999matej999/pico-kit-pcb/README.md

# Pico Kit PCB #

## Files
* [Schematic](./rpi_pico_kit/RPi-Pico-Kit.pdf)
* [Gerber](./rpi_pico_kit/gerbers/)

## 3D Model
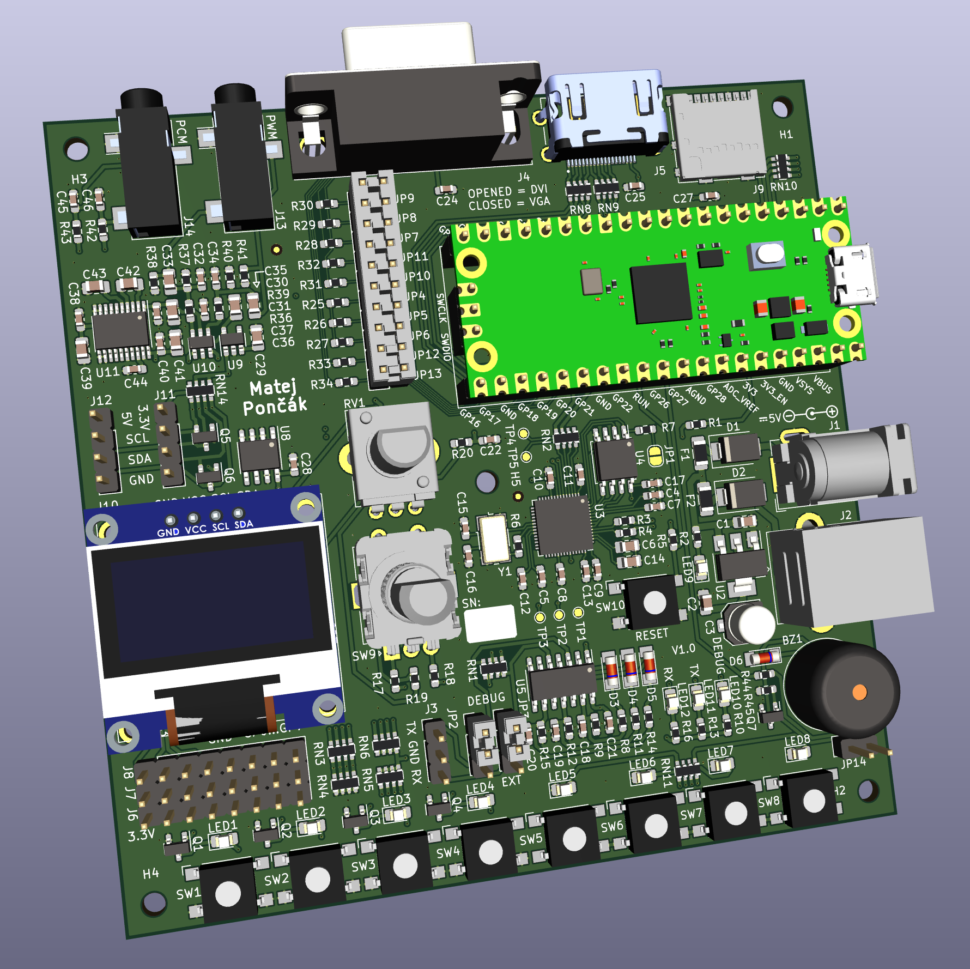
[picture p1: img/3D_model_top.png]


## Layout
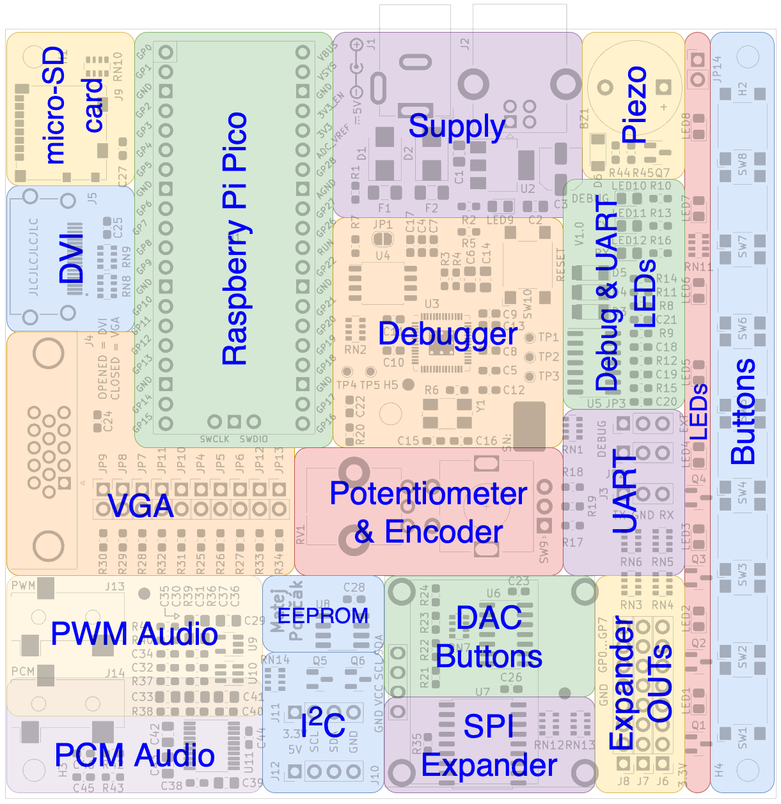
[picture p2: img/layout.png]
