999matej999/pico-kit-pcb/kit_pinout.xlsx

Sheet: Hárok1
TX + LED | GP0 | 1 | 40 | VBUS
RX + LED | GP1 | 2 | 39 | VSYS
 | GND | 3 | 38 | GND
 | GP2 | 4 | 37 | 3V3_EN
 | GP3 | 5 | 36 | 3V3(OUT)
SDA | GP4 | 6 | 35
SCL | GP5 | 7 | 34 | GP28 | ENC_BUTTON
 | GND | 8 | 33 | GND
LED1 | GP6 | 9 | 32 | GP27 | TEMP
LED2 | GP7 | 10 | 31 | GP26 | BUTTONS
LED3/L/I2S | GP8 | 11 | 30 | RUN | RESET
LED4/R/I2S | GP9 | 12 | 29 | GP22 | ENC_B
 | GND | 13 | 28 | GND
I2S | GP10 | 14 | 27 | GP21 | ENC_A
VGA | GP11 | 15 | 26 | GP20 | VGA
VGA/HDMI | GP12 | 16 | 25 | GP19 | VGA/HDMI
VGA/HDMI | GP13 | 17 | 24 | GP18 | VGA/HDMI
 | GND | 18 | 23 | GND
VGA/HDMI | GP14 | 19 | 22 | GP17 | VGA/HDMI
VGA/HDMI | GP15 | 20 | 21 | GP16 | VGA/HDMI

Sheet: Hárok2
TX + LED | GP0 | 1 | 40 | VBUS
RX + LED | GP1 | 2 | 39 | VSYS
 | GND | 3 | 38 | GND
SDA | GP2 | 4 | 37 | 3V3_EN
SCL | GP3 | 5 | 36 | 3V3(OUT)
SPI RX (MISO) | GP4 | 6 | 35
SPI SD CS | GP5 | 7 | 34 | GP28 | DAC_BUTTONS
 | GND | 8 | 33 | GND
LED1/SPI SCK | GP6 | 9 | 32 | GP27 | POTENTIOMETER
LED2/SPI TX (MOSI) | GP7 | 10 | 31 | GP26 | SPI EXPANDER CS
LED3/PWM L/I2S_LRCK | GP8 | 11 | 30 | RUN | RESET
LED4/PWM R/I2S_BCK | GP9 | 12 | 29 | GP22 | ENC_B
 | GND | 13 | 28 | GND
PIEZO/I2S_DIN | GP10 | 14 | 27 | GP21 | ENC_A
VGA_B0/ENC_SW | GP11 | 15 | 26 | GP20 | VGA_VSYNC
VGA_B1/DVI_D0+ | GP12 | 16 | 25 | GP19 | VGA_HSYNC/DVI_D1-
VGA_G0/DVI_D0- | GP13 | 17 | 24 | GP18 | VGA_R2/DVI_D1+
 | GND | 18 | 23 | GND
VGA_G1/DVI_CLK+ | GP14 | 19 | 22 | GP17 | VGA_R1/DVI_D2-
VGA_G2/DVI_CLK- | GP15 | 20 | 21 | GP16 | VGA_R0/DVI_D2+
