999matej999/pico-kit-pcb/rpi_pico_kit/3D_models/jumper.stp

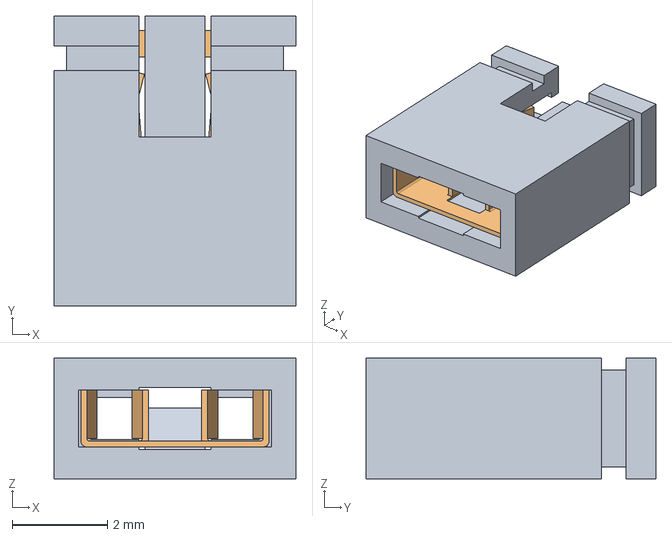
[picture p3: CAD file, 2022-03-21]
rpi_pico_kit/3D_models/jumper.stp
5.08 x 6.10 x 2.54 mm
_SNT-100-RD_body
_SNT-100_pins
