999matej999/pico-kit-pcb/rpi_pico_kit/SS-53000-001/SS-53000-001.step

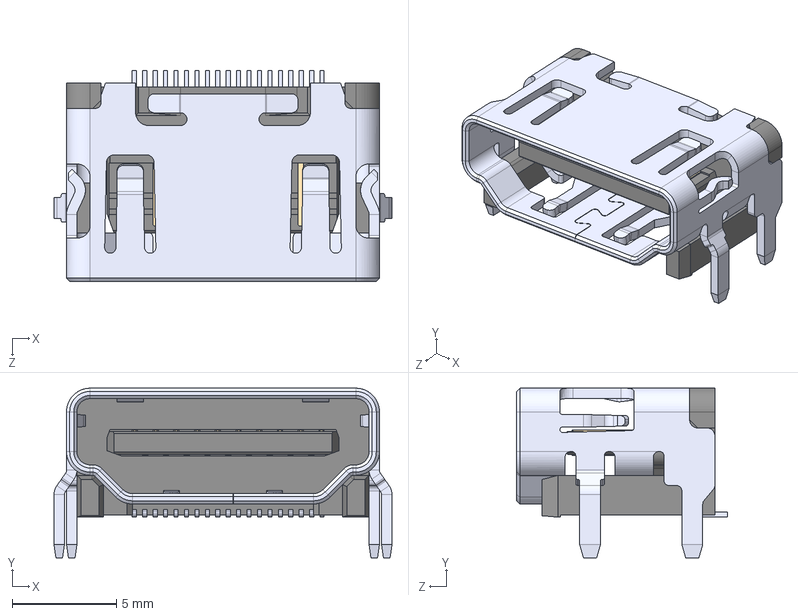
[picture p4: CAD file, 2022-03-19]
rpi_pico_kit/SS-53000-001/SS-53000-001.step
16.2 x 8.13 x 10.1 mm
