999matej999/pico-kit-pcb/rpi_pico_kit/3D_models/USB-B.stp

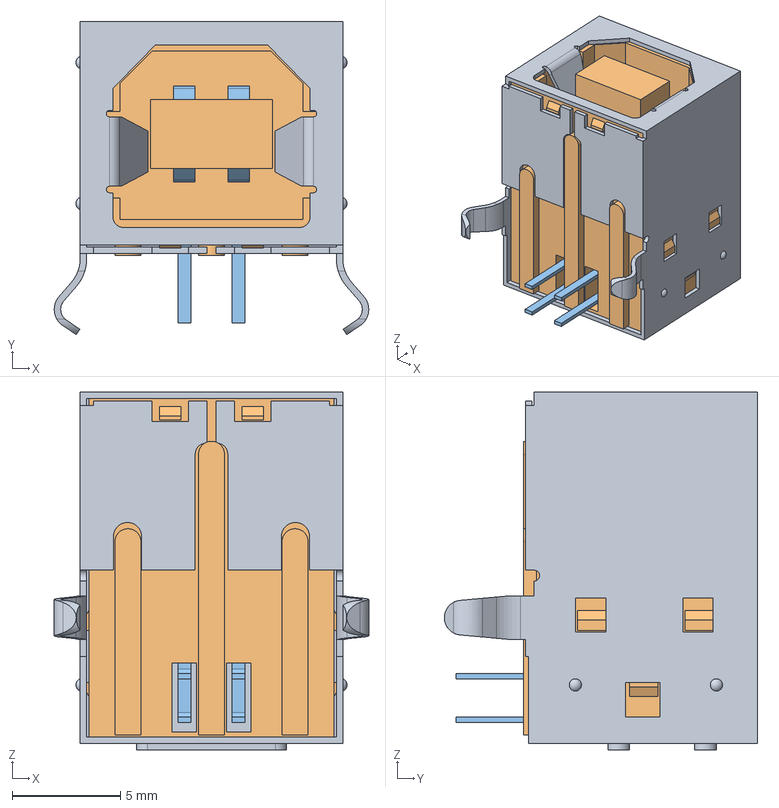
[picture p5: CAD file, 2022-03-20]
rpi_pico_kit/3D_models/USB-B.stp
14.5 x 14.4 x 16.5 mm
_USB-B-S-TH_S
_USB-B-S-B-TH_B
_USB-B-S-TH_P
