999matej999/pico-kit-pcb/rpi_pico_kit/3D_models/54-00129.step

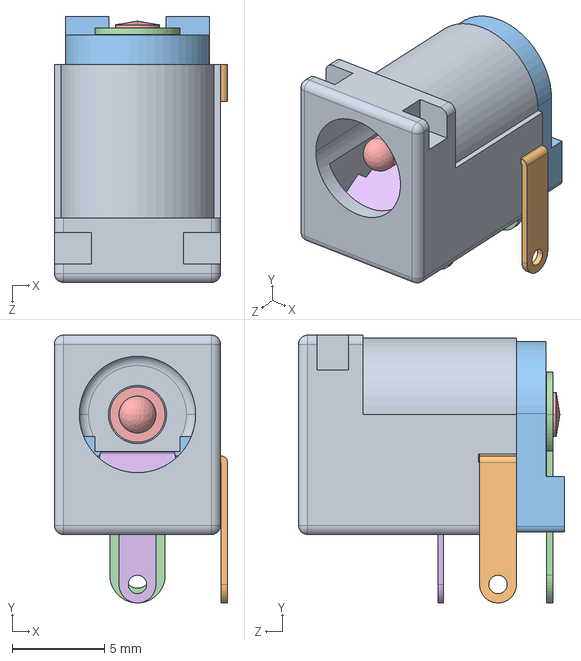
[picture p6: CAD file, 2022-03-20]
rpi_pico_kit/3D_models/54-00129.step
9.38 x 14.5 x 14.4 mm
