999matej999/pico-kit-pcb/rpi_pico_kit/3D_models/EN11-HSM1BF20.step

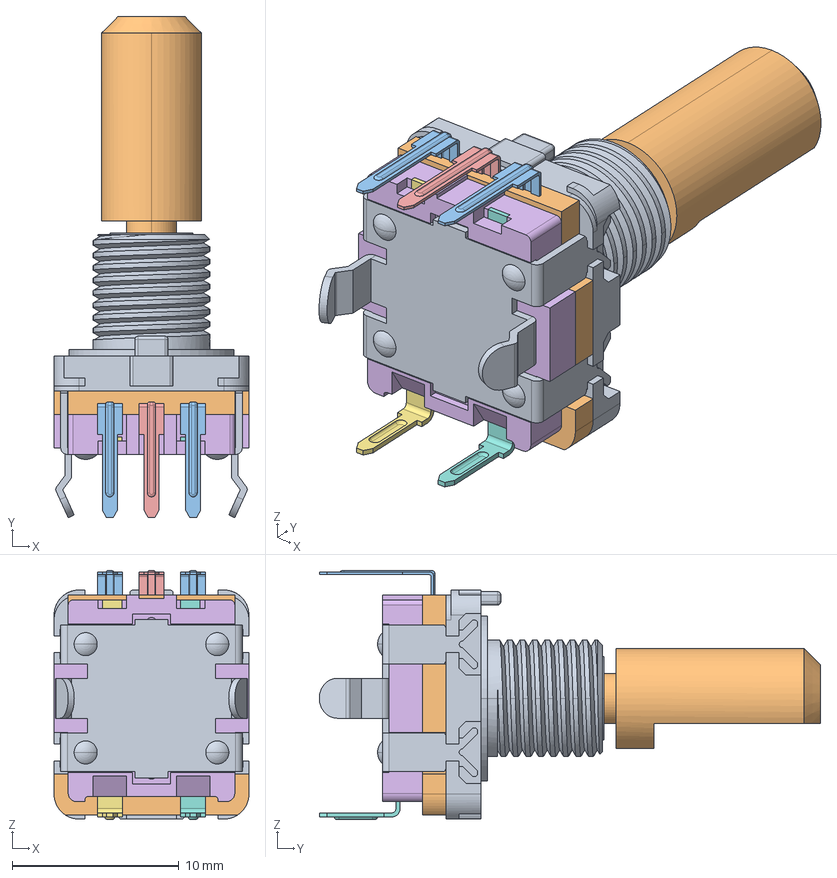
[picture p7: CAD file, 2022-03-20]
rpi_pico_kit/3D_models/EN11-HSM1BF20.step
11.7 x 30.1 x 14.9 mm
