999matej999/pico-kit-pcb/rpi_pico_kit/3D_models/OLED-128x64-0.96.step

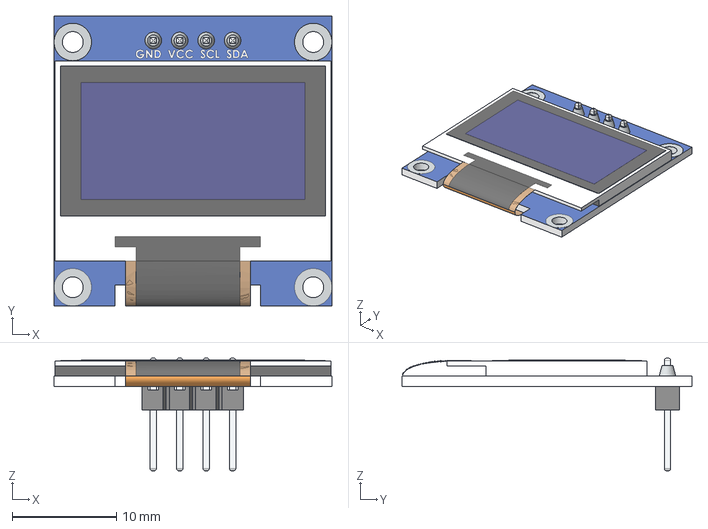
[picture p8: CAD file, 2022-03-20]
rpi_pico_kit/3D_models/OLED-128x64-0.96.step
26.7 x 27.9 x 10.8 mm
