999matej999/pico-kit-pcb/rpi_pico_kit/3D_models/ptv09a-4x20f-xxxx.stp

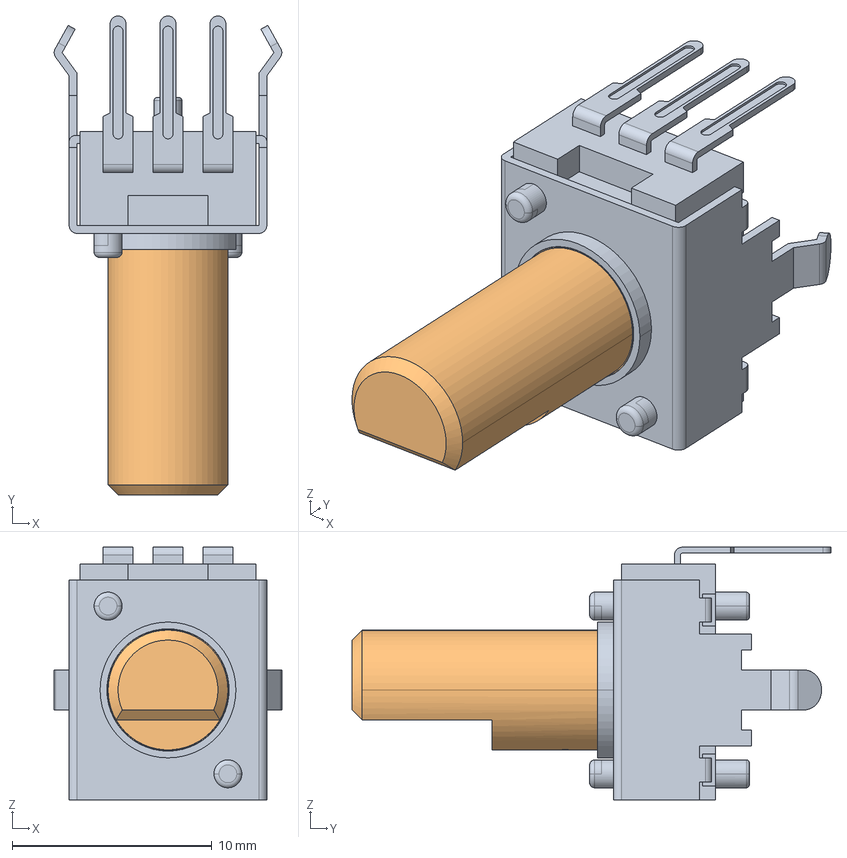
[picture p9: CAD file, 2022-03-20]
rpi_pico_kit/3D_models/ptv09a-4x20f-xxxx.stp
11.4 x 24.0 x 12.7 mm
