999matej999/pico-kit-pcb/rpi_pico_kit/3D_models/B3FS_1000.step

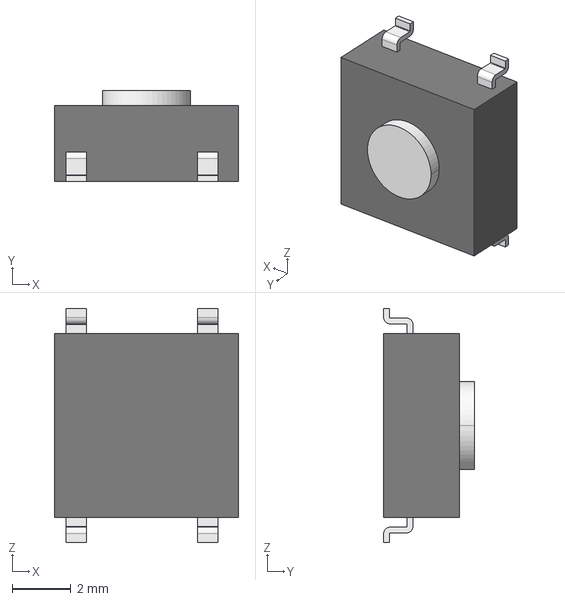
[picture p10: CAD file, 2022-03-20]
rpi_pico_kit/3D_models/B3FS_1000.step
6.30 x 3.10 x 8.00 mm
