999matej999/pico-kit-pcb/rpi_pico_kit/3D_models/CUI_DEVICES_SJ-3523-SMT-TR.step

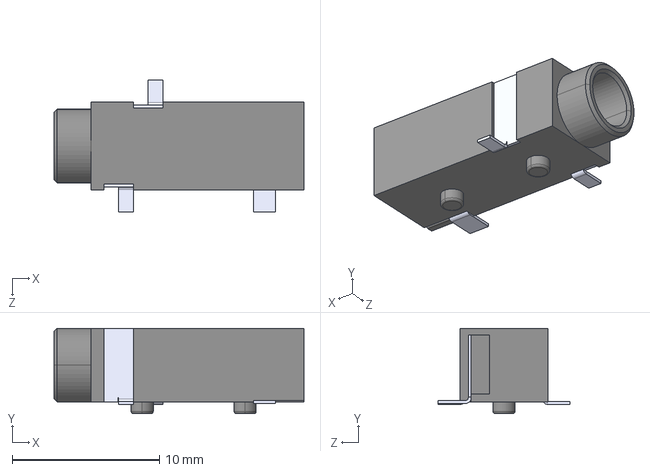
[picture p11: CAD file, 2022-03-20]
rpi_pico_kit/3D_models/CUI_DEVICES_SJ-3523-SMT-TR.step
17.0 x 5.80 x 9.00 mm
