999matej999/pico-kit-pcb/rpi_pico_kit/3D_models/Pico-R3.step

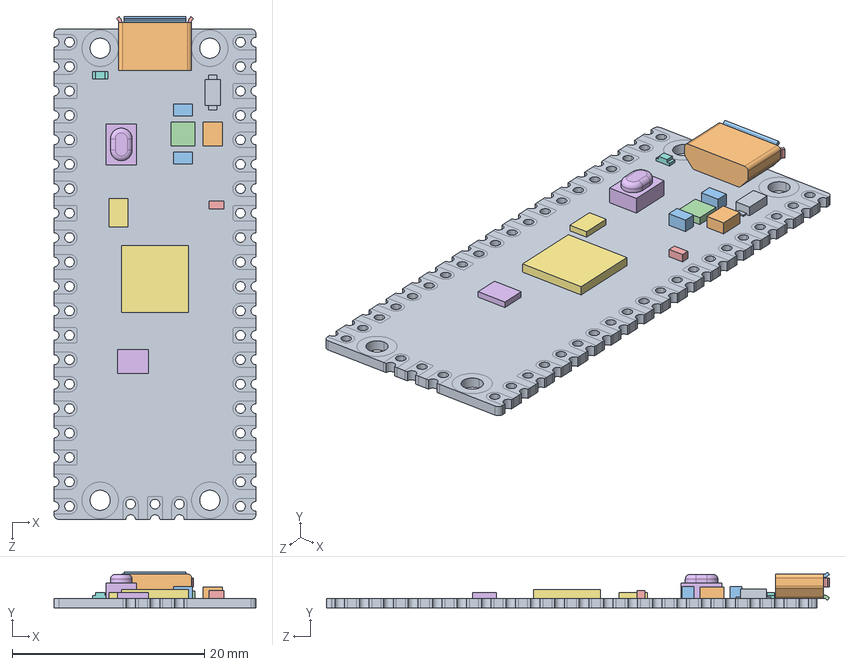
[picture p12: CAD file, 2022-01-17]
rpi_pico_kit/3D_models/Pico-R3.step
21.0 x 3.73 x 52.3 mm
PICO_REF_BOARD.STEP
PICO_REF_USB.STEP
PICO_REF_SWITCH.STEP
PICO_REF_MICROCONTROLLER.STEP
PICO_REF_LED.STEP
PICO_REF_ONSEMI.STEP
PICO_BOURNS.STEP
PICO_MURATA.STEP x 2
PICO_RICHTEK.STEP
PICO_DIODES.STEP
PICO_AEL.STEP
PICO_WINBOND.STEP
