999matej999/pico-kit-pcb/rpi_pico_kit/3D_models/1040310811.stp

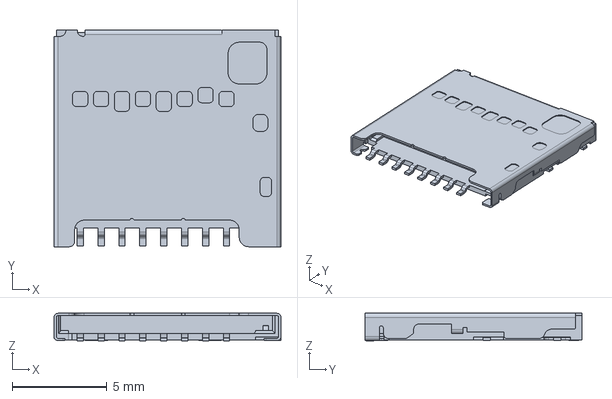
[picture p13: CAD file, 2022-03-20]
rpi_pico_kit/3D_models/1040310811.stp
11.9 x 11.4 x 1.45 mm
