999matej999/pico-kit-pcb/rpi_pico_kit/rpi_pico_kit.kicad_pcb

## KiCad design rpi_pico_kit/rpi_pico_kit.kicad_pcb (2022-03-28)

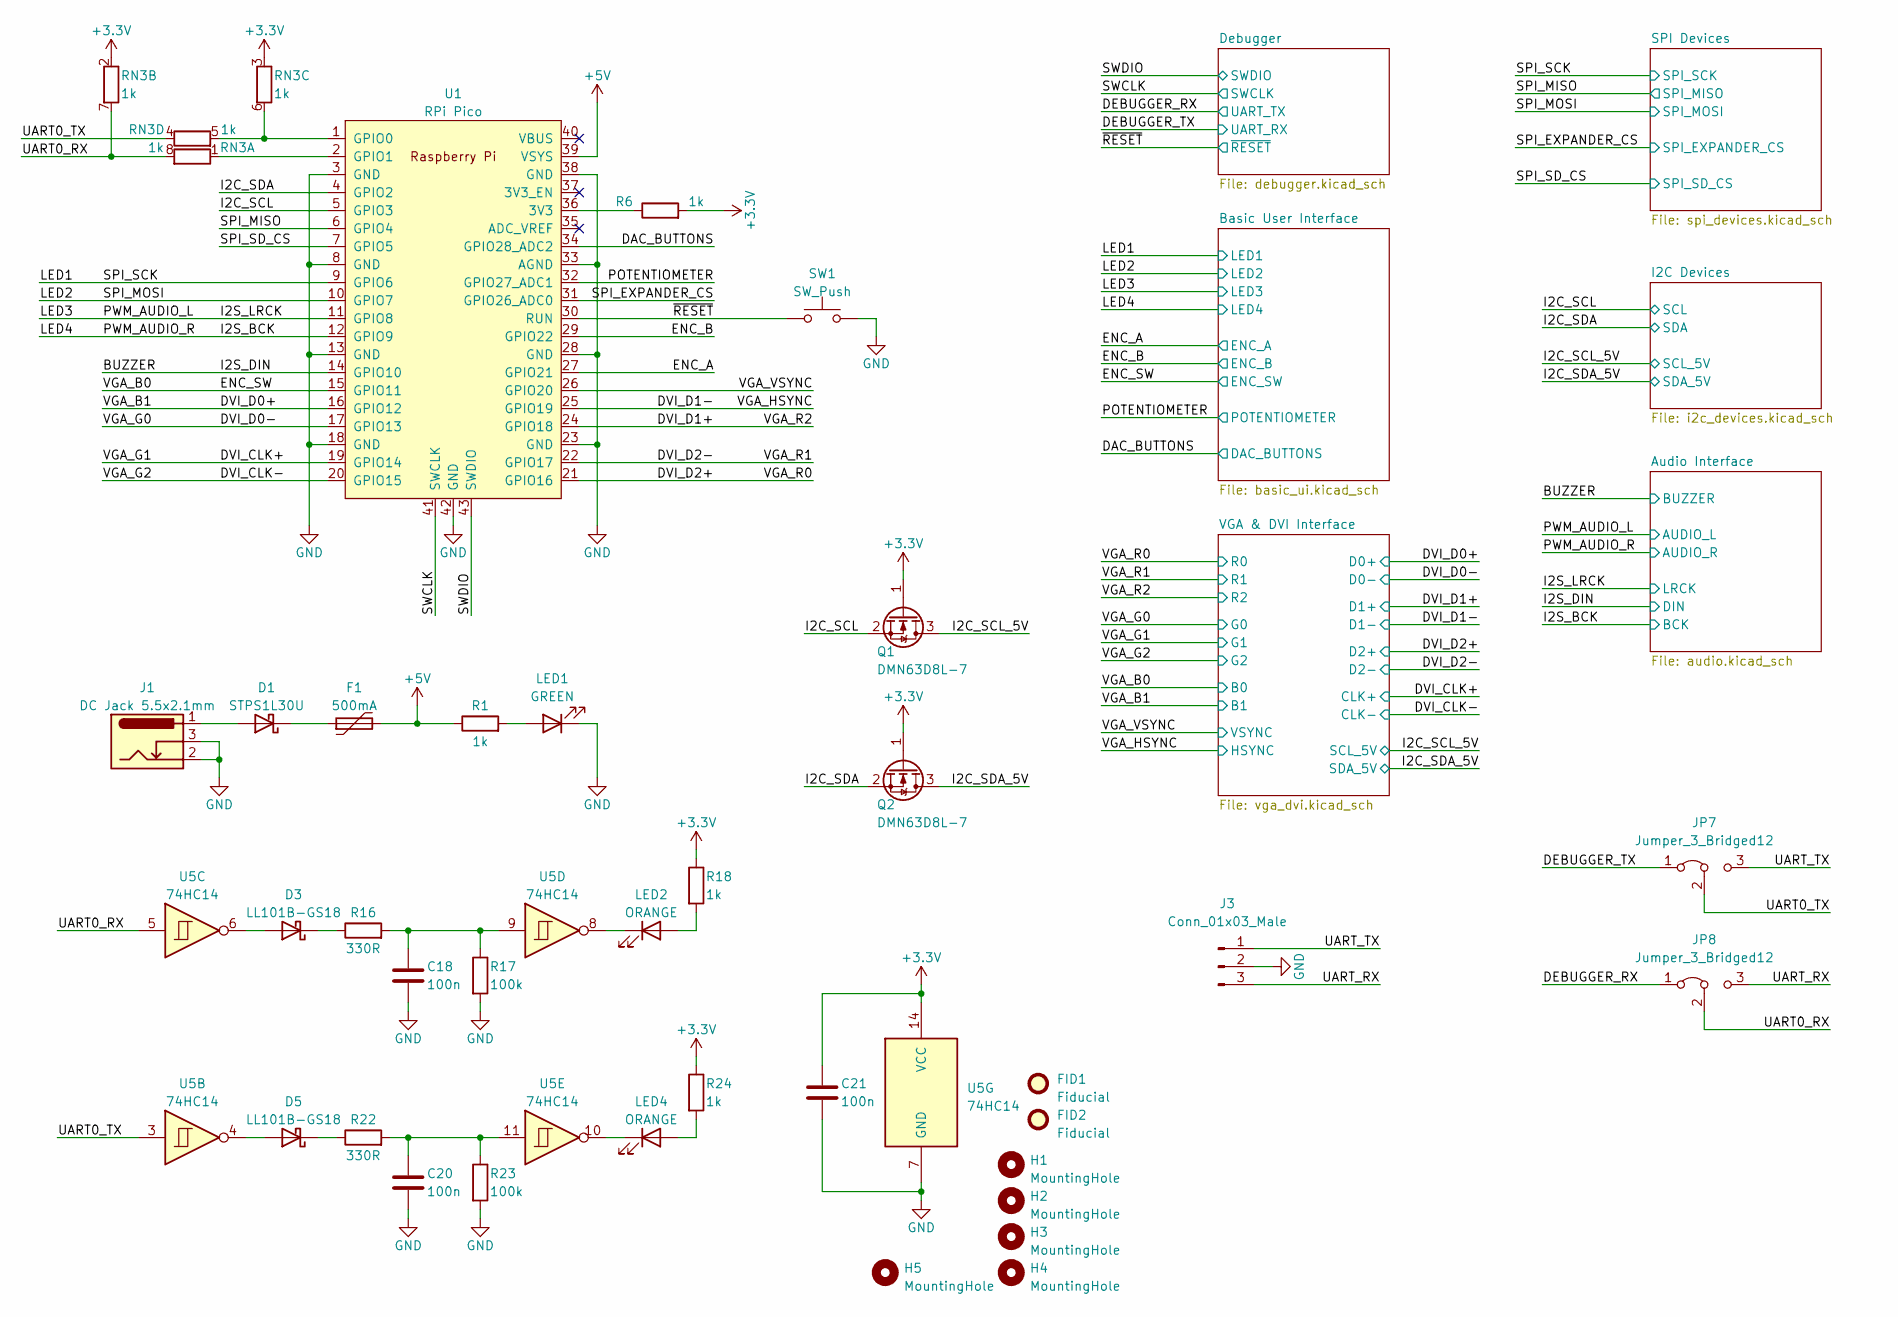
[picture p21: schematic rpi_pico_kit.kicad_sch, Raspberry Pi Pico Kit]

Parts:
C18, C20, C21: 100n; C_0603_1608Metric_Pad1.08x0.95mm_HandSolder; Manufacturer Part Number C0805C104M3RAC7800
D1: STPS1L30U; D_SMB; Manufacturer Part Number STPS1L30U
D3, D5: LL101B-GS18; D_MiniMELF; Manufacturer Part Number LL101B-GS18
F1: 500mA; Fuse_1206_3216Metric_Pad1.42x1.75mm_HandSolder; Manufacturer Part Number 0ZCJ0050FF2G
FID1, FID2: Fiducial; Fiducial_0.75mm_Mask1.5mm
H1, H2, H3, H4, H5: MountingHole; MountingHole_2.7mm_M2.5
J1: DC Jack 5.5x2.1mm; BarrelJack_GCT_DCJ200-10-A_Horizontal; Manufacturer Part Number 54-00129
J3: Conn_01x03_Male; PinHeader_1x03_P2.54mm_Vertical; Manufacturer Part Number PinHeader_1x03
JP7, JP8: Jumper_3_Bridged12; JumperTHT_3_P2.54mm_Bridged12; Manufacturer Part Number PinHeader_1x03
LED1: GREEN; LED_0805_2012Metric_Pad1.15x1.40mm_HandSolder; Manufacturer Part Number 150080VS75000
LED2, LED4: ORANGE; LED_0805_2012Metric_Pad1.15x1.40mm_HandSolder; Manufacturer Part Number LTST-C170KFKT
Q1, Q2: DMN63D8L-7; SOT-23; Manufacturer Part Number DMN63D8L-7
R1, R6, R18, R24: 1k; R_0603_1608Metric_Pad0.98x0.95mm_HandSolder; Manufacturer Part Number RC0805FR-071KL
R16, R22: 330R; R_0603_1608Metric_Pad0.98x0.95mm_HandSolder; Manufacturer Part Number RC0805FR-13330RL
R17, R23: 100k; R_0603_1608Metric_Pad0.98x0.95mm_HandSolder; Manufacturer Part Number RC0805FR-07100KL
RN3: 1k; R_Array_Convex_4x0603
SW1: SW_Push; SW_SPST_Omron_B3FS-100xP_12; Manufacturer Part Number TD-03XAT-A00-TR
U1: RPi Pico; RPi_Pico_THT_socket; Manufacturer Part Number SC0915
U5: 74HC14; SOIC-14_3.9x8.7mm_P1.27mm; Manufacturer Part Number 74HC14S14-13

Connections:
+3V3: C21.2, Q1.1 (G), Q2.1 (G), R6.2, R18.1, R24.1, RN3.2 (R2.1), RN3.3 (R3.1), U5.14 (VCC); also elsewhere on the board
+5V: F1.2, R1.1, U1.39 (VSYS); also elsewhere on the board
/BUZZER: U1.14 (GPIO10); also elsewhere on the board
/DAC_BUTTONS: U1.34 (GPIO28_ADC2); also elsewhere on the board
/DEBUGGER_RX: JP8.1 (A); also elsewhere on the board
/DEBUGGER_TX: JP7.1 (A); also elsewhere on the board
/DVI_CLK+: U1.19 (GPIO14); also elsewhere on the board
/DVI_CLK-: U1.20 (GPIO15); also elsewhere on the board
/DVI_D0+: U1.16 (GPIO12); also elsewhere on the board
/DVI_D0-: U1.17 (GPIO13); also elsewhere on the board
/DVI_D1+: U1.24 (GPIO18); also elsewhere on the board
/DVI_D1-: U1.25 (GPIO19); also elsewhere on the board
/DVI_D2+: U1.21 (GPIO16); also elsewhere on the board
/DVI_D2-: U1.22 (GPIO17); also elsewhere on the board
/ENC_A: U1.27 (GPIO21); also elsewhere on the board
/ENC_B: U1.29 (GPIO22); also elsewhere on the board
/ENC_SW: U1.15 (GPIO11); also elsewhere on the board
/I2C_SCL: Q1.2 (S), U1.5 (GPIO3); also elsewhere on the board
/I2C_SCL_5V: Q1.3 (D); also elsewhere on the board
/I2C_SDA: Q2.2 (S), U1.4 (GPIO2); also elsewhere on the board
/I2C_SDA_5V: Q2.3 (D); also elsewhere on the board
/I2S_BCK: U1.12 (GPIO9); also elsewhere on the board
/I2S_LRCK: U1.11 (GPIO8); also elsewhere on the board
/LED1: U1.9 (GPIO6); also elsewhere on the board
/LED2: U1.10 (GPIO7); also elsewhere on the board
/POTENTIOMETER: U1.32 (GPIO27_ADC1); also elsewhere on the board
/SPI_EXPANDER_CS: U1.31 (GPIO26_ADC0); also elsewhere on the board
/SPI_MISO: U1.6 (GPIO4); also elsewhere on the board
/SPI_SD_CS: U1.7 (GPIO5); also elsewhere on the board
/SWCLK: U1.41 (SWCLK); also elsewhere on the board
/SWDIO: U1.43 (SWDIO); also elsewhere on the board
/UART0_RX: JP8.2 (C), RN3.7 (R2.2), RN3.8 (R1.2), U5.5
/UART0_TX: JP7.2 (C), RN3.4 (R4.1), U5.3
/UART_RX: J3.3, JP8.3 (B)
/UART_TX: J3.1, JP7.3 (B)
/VGA_VSYNC: U1.26 (GPIO20); also elsewhere on the board
/~RESET: SW1.1, U1.30 (RUN); also elsewhere on the board
GND: C18.1, C20.1, C21.1, J1.2, J1.3, J3.2, LED1.1 (K), R17.2, R23.2, SW1.2, U1.3 (GND), U1.8 (GND), U1.13 (GND), U1.18 (GND), U1.23 (GND), U1.28 (GND), U1.33 (AGND), U1.38 (GND), U1.42 (GND), U5.7 (GND); also elsewhere on the board
unnamed: C18.2, R16.2, R17.1, U5.9
unnamed: C20.2, R22.2, R23.1, U5.11
unnamed: D1.2 (A), J1.1
unnamed: D1.1 (K), F1.1
unnamed: D3.2 (A), U5.6
unnamed: D3.1 (K), R16.1
unnamed: D5.2 (A), U5.4
unnamed: D5.1 (K), R22.1
unnamed: LED1.2 (A), R1.2
unnamed: LED2.2 (A), R18.2
unnamed: LED2.1 (K), U5.8
unnamed: LED4.2 (A), R24.2
unnamed: LED4.1 (K), U5.10
unnamed: RN3.1 (R1.1), U1.2 (GPIO1)
unnamed: RN3.5 (R4.2), RN3.6 (R3.2), U1.1 (GPIO0)
unnamed: R6.1, U1.36 (3V3)

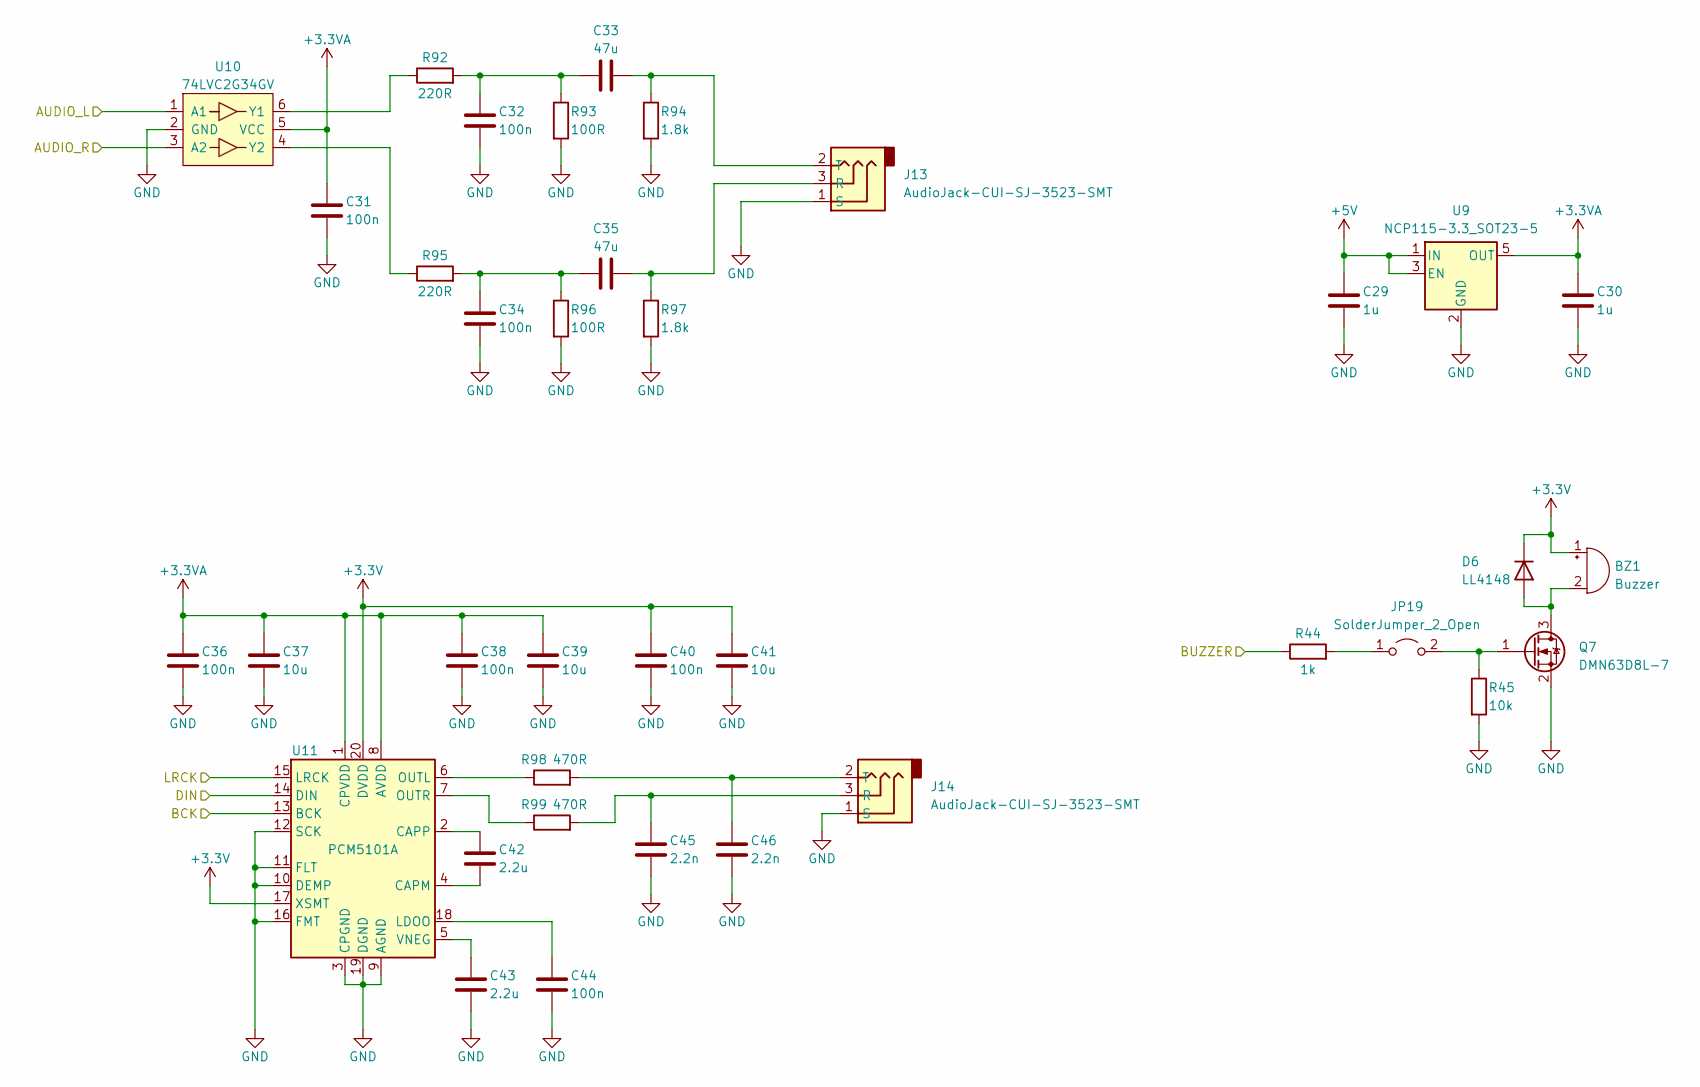
[picture p22: schematic audio.kicad_sch, Raspberry Pi Pico Kit]

Parts:
BZ1: Buzzer; Buzzer_12x9.5RM7.6; Manufacturer Part Number LA216001
C29, C30: 1u; C_0805_2012Metric_Pad1.18x1.45mm_HandSolder; Manufacturer Part Number C0805C105Z4VAC7800
C31, C32, C34, C36, C38, C40, C44: 100n; C_0603_1608Metric_Pad1.08x0.95mm_HandSolder; Manufacturer Part Number C0805C104M3RAC7800
C33, C35: 47u; C_0805_2012Metric_Pad1.18x1.45mm_HandSolder; Manufacturer Part Number CL21A476MRYNNNE
C37, C39, C41: 10u; C_0805_2012Metric_Pad1.18x1.45mm_HandSolder; Manufacturer Part Number CL21A106KOQNNNG
C42, C43: 2.2u; C_0805_2012Metric_Pad1.18x1.45mm_HandSolder; Manufacturer Part Number C0805C225Z4VAC7800
C45, C46: 2.2n; C_0603_1608Metric_Pad1.08x0.95mm_HandSolder; Manufacturer Part Number C0805C222K5RAC7800
D6: LL4148; D_MiniMELF; Manufacturer Part Number LL4148
J13, J14: AudioJack-CUI-SJ-3523-SMT; CUI_SJ-3523-audio-jack; Manufacturer Part Number SJ-3523-SMT-TR
JP19: SolderJumper_2_Open; JumperTHT_2_P2.54mm_Open; Manufacturer Part Number PinHeader_1x02
Q7: DMN63D8L-7; SOT-23; Manufacturer Part Number DMN63D8L-7
R44: 1k; R_0603_1608Metric_Pad0.98x0.95mm_HandSolder; Manufacturer Part Number RC0805FR-071KL
R45: 10k; R_0603_1608Metric_Pad0.98x0.95mm_HandSolder; Manufacturer Part Number RC0805FR-0710KL
R92, R95: 220R; R_0603_1608Metric_Pad0.98x0.95mm_HandSolder; Manufacturer Part Number RC0805FR-07220RL
R93, R96: 100R; R_0603_1608Metric_Pad0.98x0.95mm_HandSolder; Manufacturer Part Number RC0805FR-07100RL
R94, R97: 1.8k; R_0603_1608Metric_Pad0.98x0.95mm_HandSolder; Manufacturer Part Number RC0805FR-071K8L
R98, R99: 470R; R_0603_1608Metric_Pad0.98x0.95mm_HandSolder; Manufacturer Part Number RC0805FR-07470RL
U9: NCP115-3.3_SOT23-5; SOT-23-5; Manufacturer Part Number NCP115ASN330T2G
U10: 74LVC2G34GV; SC-74-6_1.5x2.9mm_P0.95mm; Manufacturer Part Number 74LVC2G34GV,125
U11: PCM5101A; TSSOP-20_4.4x6.5mm_P0.65mm

Connections:
+3.3VA: C30.2, C31.2, C36.2, C37.2, C38.2, C39.2, U9.5 (OUT), U10.5 (VCC), U11.1 (CPVDD), U11.8 (AVDD)
+3V3: BZ1.1 (-), C40.2, C41.2, D6.1 (K), U11.17 (XSMT), U11.20 (DVDD); also elsewhere on the board
+5V: C29.2, U9.1 (IN), U9.3 (EN); also elsewhere on the board
/BUZZER: R44.1, U11.14 (DIN); also elsewhere on the board
/I2S_BCK: U10.3 (A2), U11.13 (BCK); also elsewhere on the board
/I2S_LRCK: U10.1 (A1), U11.15 (LRCK); also elsewhere on the board
GND: C29.1, C30.1, C31.1, C32.1, C34.1, C36.1, C37.1, C38.1, C39.1, C40.1, C41.1, C43.1, C44.1, C45.1, C46.1, J13.1 (S), J14.1 (S), Q7.2 (S), R45.2, R93.2, R94.2, R96.2, R97.2, U9.2 (GND), U10.2 (GND), U11.3 (CPGND), U11.9 (AGND), U11.10 (DEMP), U11.11 (FLT), U11.12 (SCK), U11.16 (FMT), U11.19 (DGND); also elsewhere on the board
unnamed: BZ1.2 (+), D6.2 (A), Q7.3 (D)
unnamed: C32.2, C33.1, R92.2, R93.1
unnamed: C34.2, C35.1, R95.2, R96.1
unnamed: C35.2, J13.3 (R), R97.1
unnamed: C33.2, J13.2 (T), R94.1
unnamed: C45.2, J14.3 (R), R99.2
unnamed: C46.2, J14.2 (T), R98.2
unnamed: JP19.1 (A), R44.2
unnamed: JP19.2 (B), Q7.1 (G), R45.1
unnamed: R92.1, U10.6 (Y1)
unnamed: R95.1, U10.4 (Y2)
unnamed: C42.1, U11.4 (CAPM)
unnamed: C42.2, U11.2 (CAPP)
unnamed: C44.2, U11.18 (LDOO)
unnamed: R98.1, U11.6 (OUTL)
unnamed: R99.1, U11.7 (OUTR)
unnamed: C43.2, U11.5 (VNEG)

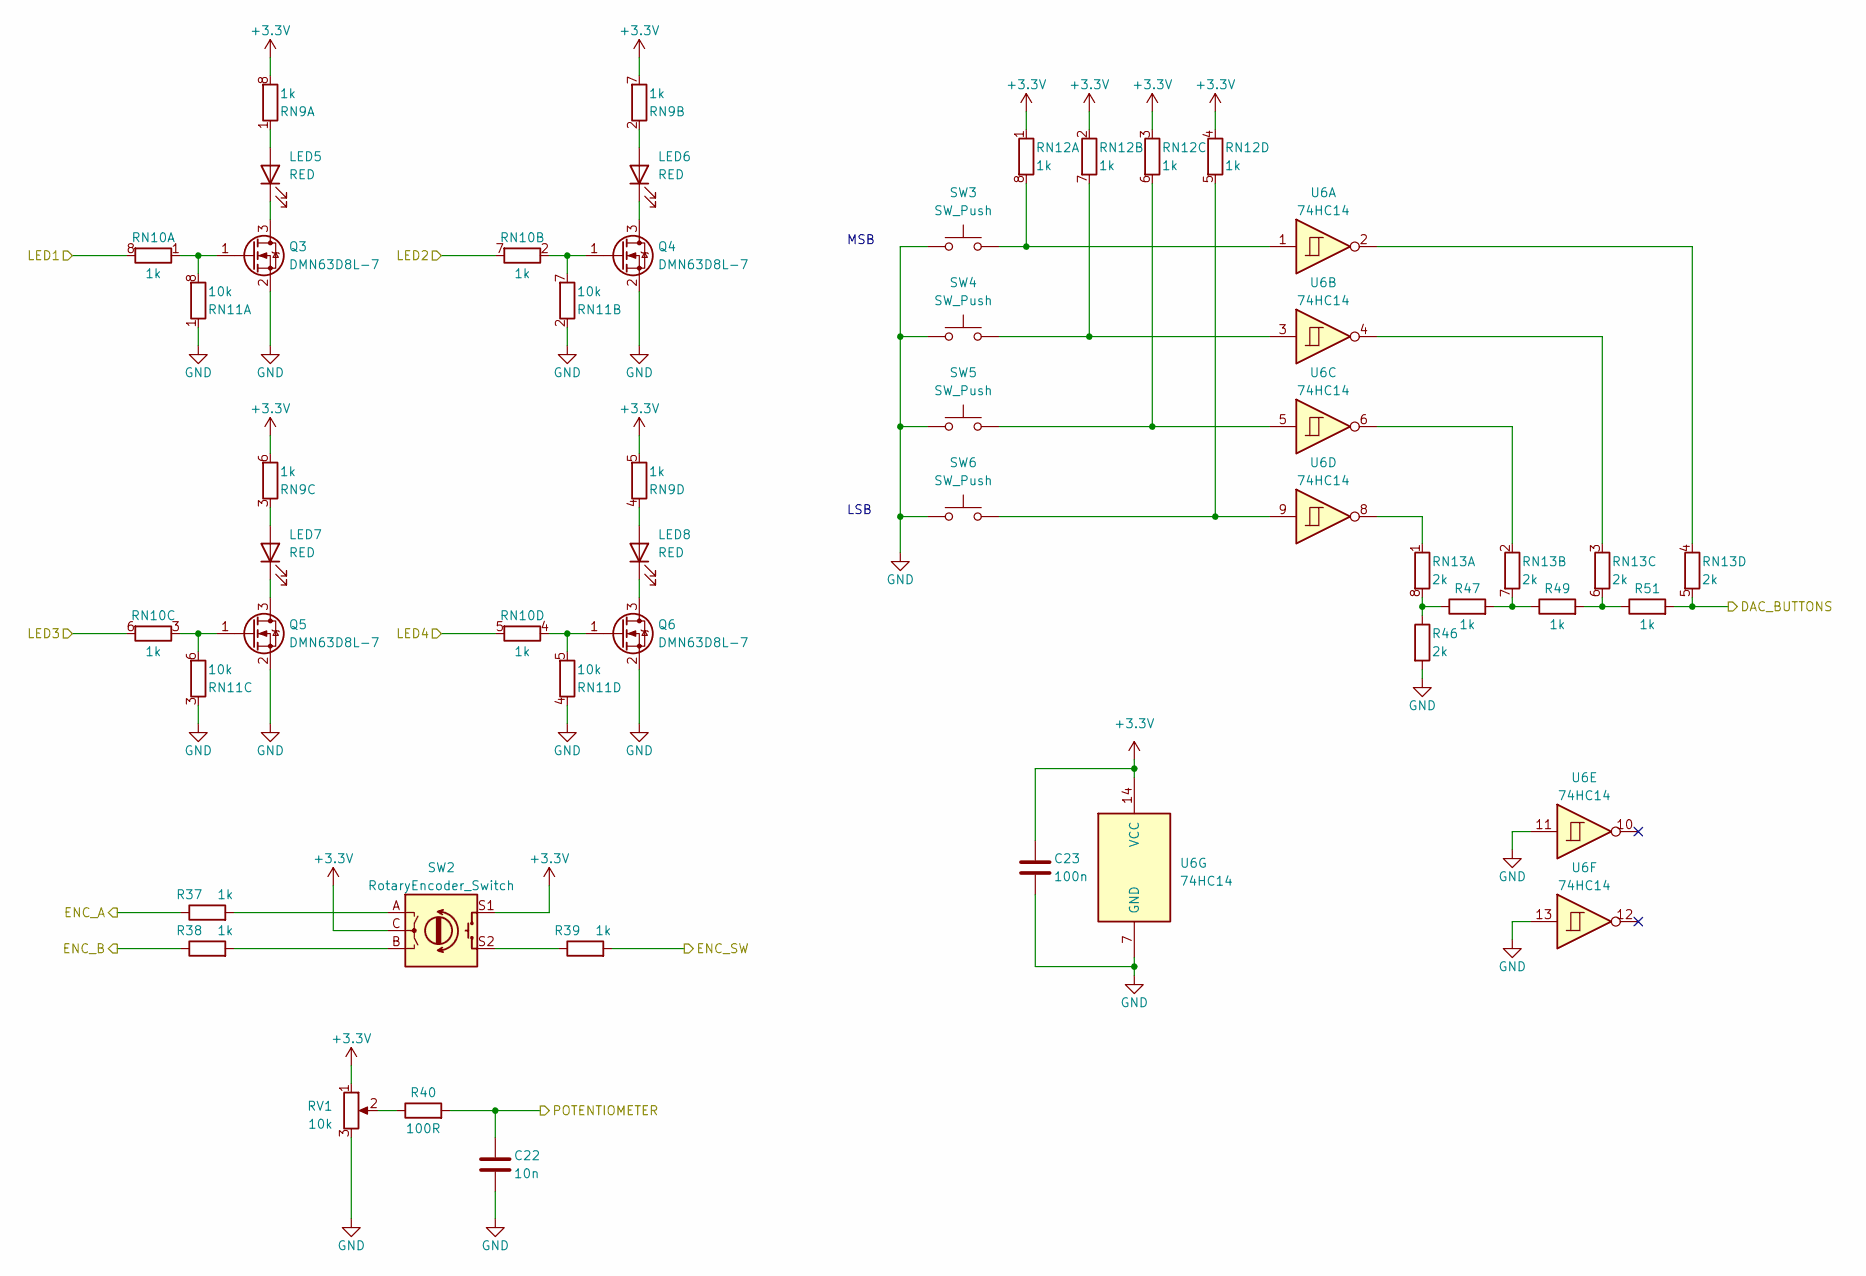
[picture p23: schematic basic_ui.kicad_sch, Raspberry Pi Pico Kit]

Parts:
C22: 10n; C_0603_1608Metric_Pad1.08x0.95mm_HandSolder; Manufacturer Part Number C0805C103K5RAC7210
C23: 100n; C_0603_1608Metric_Pad1.08x0.95mm_HandSolder; Manufacturer Part Number C0805C104M3RAC7800
LED5, LED6, LED7, LED8: RED; LED_0805_2012Metric_Pad1.15x1.40mm_HandSolder; Manufacturer Part Number 150080SS75000
Q3, Q4, Q5, Q6: DMN63D8L-7; SOT-23; Manufacturer Part Number DMN63D8L-7
R37, R38, R39, R47, R49, R51: 1k; R_0603_1608Metric_Pad0.98x0.95mm_HandSolder; Manufacturer Part Number RC0805FR-071KL
R40: 100R; R_0603_1608Metric_Pad0.98x0.95mm_HandSolder; Manufacturer Part Number RC0805FR-07100RL
R46: 2k; R_0603_1608Metric_Pad0.98x0.95mm_HandSolder; Manufacturer Part Number RC0805FR-072KL
RN9, RN10, RN12: 1k; R_Array_Convex_4x0603
RN11: 10k; R_Array_Convex_4x0603
RN13: 2k; R_Array_Convex_4x0603
RV1: 10k; Potentiometer_Bourns_PTV09A-1_Single_Vertical; Manufacturer Part Number PT01-B125D-B103
SW2: RotaryEncoder_Switch; RotaryEncoder_Alps_EC11E-Switch_Vertical_H20mm; Manufacturer Part Number EN11-HSM1BF20
SW3, SW4, SW5, SW6: SW_Push; SW_SPST_Omron_B3FS-100xP_12; Manufacturer Part Number TD-03XAT-A00-TR
U6: 74HC14; SOIC-14_3.9x8.7mm_P1.27mm; Manufacturer Part Number 74HC14S14-13

Connections:
+3V3: C23.2, RN9.5 (R4.2), RN9.6 (R3.2), RN9.7 (R2.2), RN9.8 (R1.2), RN12.1 (R1.1), RN12.2 (R2.1), RN12.3 (R3.1), RN12.4 (R4.1), RV1.1, SW2.C, SW2.S1, U6.14 (VCC); also elsewhere on the board
/DAC_BUTTONS: R51.2, RN13.5 (R4.2); also elsewhere on the board
/ENC_A: R37.1; also elsewhere on the board
/ENC_B: R38.1; also elsewhere on the board
/ENC_SW: R39.2; also elsewhere on the board
/I2S_BCK: RN10.5 (R4.2); also elsewhere on the board
/I2S_LRCK: RN10.6 (R3.2); also elsewhere on the board
/LED1: RN10.8 (R1.2); also elsewhere on the board
/LED2: RN10.7 (R2.2); also elsewhere on the board
/POTENTIOMETER: C22.1, R40.2; also elsewhere on the board
GND: C22.2, C23.1, Q3.2 (S), Q4.2 (S), Q5.2 (S), Q6.2 (S), R46.2, RN11.1 (R1.1), RN11.2 (R2.1), RN11.3 (R3.1), RN11.4 (R4.1), RV1.3, SW3.2, SW4.2, SW5.2, SW6.2, U6.7 (GND), U6.11, U6.13; also elsewhere on the board
unnamed: LED5.2 (A), RN9.1 (R1.1)
unnamed: LED5.1 (K), Q3.3 (D)
unnamed: LED6.2 (A), RN9.2 (R2.1)
unnamed: LED6.1 (K), Q4.3 (D)
unnamed: LED7.2 (A), RN9.3 (R3.1)
unnamed: LED7.1 (K), Q5.3 (D)
unnamed: LED8.2 (A), RN9.4 (R4.1)
unnamed: LED8.1 (K), Q6.3 (D)
unnamed: Q3.1 (G), RN10.1 (R1.1), RN11.8 (R1.2)
unnamed: Q4.1 (G), RN10.2 (R2.1), RN11.7 (R2.2)
unnamed: Q5.1 (G), RN10.3 (R3.1), RN11.6 (R3.2)
unnamed: Q6.1 (G), RN10.4 (R4.1), RN11.5 (R4.2)
unnamed: R37.2, SW2.A
unnamed: R38.2, SW2.B
unnamed: R39.1, SW2.S2
unnamed: R40.1, RV1.2
unnamed: RN12.8 (R1.2), SW3.1, U6.1
unnamed: RN12.7 (R2.2), SW4.1, U6.3
unnamed: RN12.6 (R3.2), SW5.1, U6.5
unnamed: RN12.5 (R4.2), SW6.1, U6.9
unnamed: RN13.1 (R1.1), U6.8
unnamed: R46.1, R47.1, RN13.8 (R1.2)
unnamed: RN13.2 (R2.1), U6.6
unnamed: R47.2, R49.1, RN13.7 (R2.2)
unnamed: RN13.3 (R3.1), U6.4
unnamed: R49.2, R51.1, RN13.6 (R3.2)
unnamed: RN13.4 (R4.1), U6.2

Notes on the sheet:
LSB
MSB

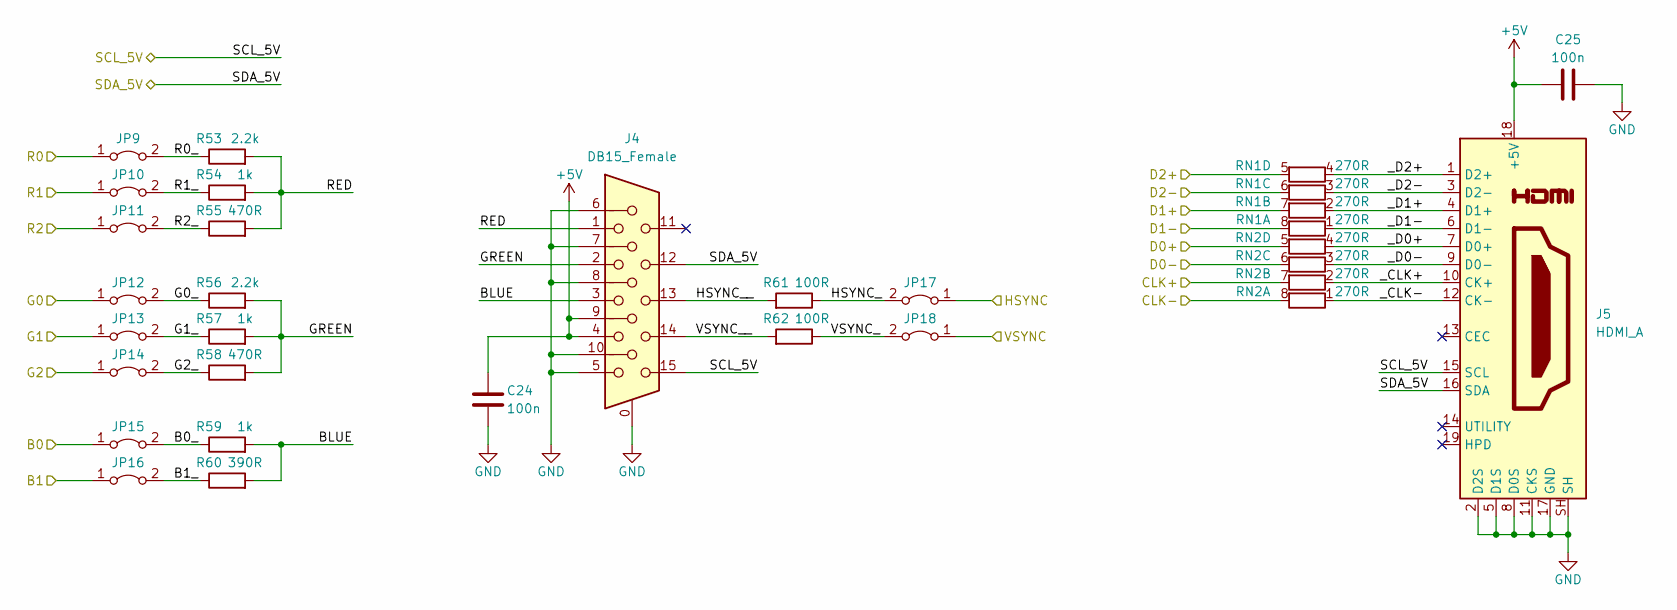
[picture p24: schematic vga_dvi.kicad_sch, Raspberry Pi Pico Kit]

Parts:
C24, C25: 100n; C_0603_1608Metric_Pad1.08x0.95mm_HandSolder; Manufacturer Part Number C0805C104M3RAC7800
J4: DB15_Female; DSUB-15-HD_Female_Horizontal_P2.29x1.98mm_EdgePinOffset3.03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
J5: HDMI_A; STEWART_SS-53000-001; Manufacturer Part Number SS-53000-001
JP9, JP10, JP11, JP12, JP13, JP14, JP15, JP16, JP17, JP18: Jumper_2_Bridged; JumperTHT_2_P2.54mm_Bridged; Manufacturer Part Number PinHeader_1x02
R53, R56: 2.2k; R_0603_1608Metric_Pad0.98x0.95mm_HandSolder; Manufacturer Part Number RC0805FR-072K2L
R54, R57, R59: 1k; R_0603_1608Metric_Pad0.98x0.95mm_HandSolder; Manufacturer Part Number RC0805FR-071KL
R55, R58: 470R; R_0603_1608Metric_Pad0.98x0.95mm_HandSolder; Manufacturer Part Number RC0805FR-07470RL
R60: 390R; R_0603_1608Metric_Pad0.98x0.95mm_HandSolder; Manufacturer Part Number RC0805FR-07390RL
R61, R62: 100R; R_0603_1608Metric_Pad0.98x0.95mm_HandSolder; Manufacturer Part Number RC0805FR-07100RL
RN1, RN2: 270R; R_Array_Convex_4x0603

Connections:
+5V: C24.2, C25.1, J4.4, J4.9, J5.18 (+5V); also elsewhere on the board
/DVI_CLK+: JP13.1 (A), RN2.7 (R2.2); also elsewhere on the board
/DVI_CLK-: JP14.1 (A), RN2.8 (R1.2); also elsewhere on the board
/DVI_D0+: JP16.1 (A), RN2.5 (R4.2); also elsewhere on the board
/DVI_D0-: JP12.1 (A), RN2.6 (R3.2); also elsewhere on the board
/DVI_D1+: JP11.1 (A), RN1.7 (R2.2); also elsewhere on the board
/DVI_D1-: JP17.1 (A), RN1.8 (R1.2); also elsewhere on the board
/DVI_D2+: JP9.1 (A), RN1.5 (R4.2); also elsewhere on the board
/DVI_D2-: JP10.1 (A), RN1.6 (R3.2); also elsewhere on the board
/ENC_SW: JP15.1 (A); also elsewhere on the board
/I2C_SCL_5V: J4.15, J5.15 (SCL); also elsewhere on the board
/I2C_SDA_5V: J4.12, J5.16 (SDA); also elsewhere on the board
/VGA & DVI Interface/B0_: JP15.2 (B), R59.1
/VGA & DVI Interface/B1_: JP16.2 (B), R60.1
/VGA & DVI Interface/BLUE: J4.3, R59.2, R60.2
/VGA & DVI Interface/G0_: JP12.2 (B), R56.1
/VGA & DVI Interface/G1_: JP13.2 (B), R57.1
/VGA & DVI Interface/G2_: JP14.2 (B), R58.1
/VGA & DVI Interface/GREEN: J4.2, R56.2, R57.2, R58.2
/VGA & DVI Interface/HSYNC_: JP17.2 (B), R61.1
/VGA & DVI Interface/HSYNC__: J4.13, R61.2
/VGA & DVI Interface/R0_: JP9.2 (B), R53.1
/VGA & DVI Interface/R1_: JP10.2 (B), R54.1
/VGA & DVI Interface/R2_: JP11.2 (B), R55.1
/VGA & DVI Interface/RED: J4.1, R53.2, R54.2, R55.2
/VGA & DVI Interface/VSYNC_: JP18.2 (B), R62.1
/VGA & DVI Interface/VSYNC__: J4.14, R62.2
/VGA & DVI Interface/_CLK+: J5.10 (CK+), RN2.2 (R2.1)
/VGA & DVI Interface/_CLK-: J5.12 (CK-), RN2.1 (R1.1)
/VGA & DVI Interface/_D0+: J5.7 (D0+), RN2.4 (R4.1)
/VGA & DVI Interface/_D0-: J5.9 (D0-), RN2.3 (R3.1)
/VGA & DVI Interface/_D1+: J5.4 (D1+), RN1.2 (R2.1)
/VGA & DVI Interface/_D1-: J5.6 (D1-), RN1.1 (R1.1)
/VGA & DVI Interface/_D2+: J5.1 (D2+), RN1.4 (R4.1)
/VGA & DVI Interface/_D2-: J5.3 (D2-), RN1.3 (R3.1)
/VGA_VSYNC: JP18.1 (A); also elsewhere on the board
GND: C24.1, C25.2, J4.0, J4.5, J4.6, J4.7, J4.8, J4.10, J5.2 (D2S), J5.5 (D1S), J5.8 (D0S), J5.11 (CKS), J5.17 (GND), J5.SH; also elsewhere on the board

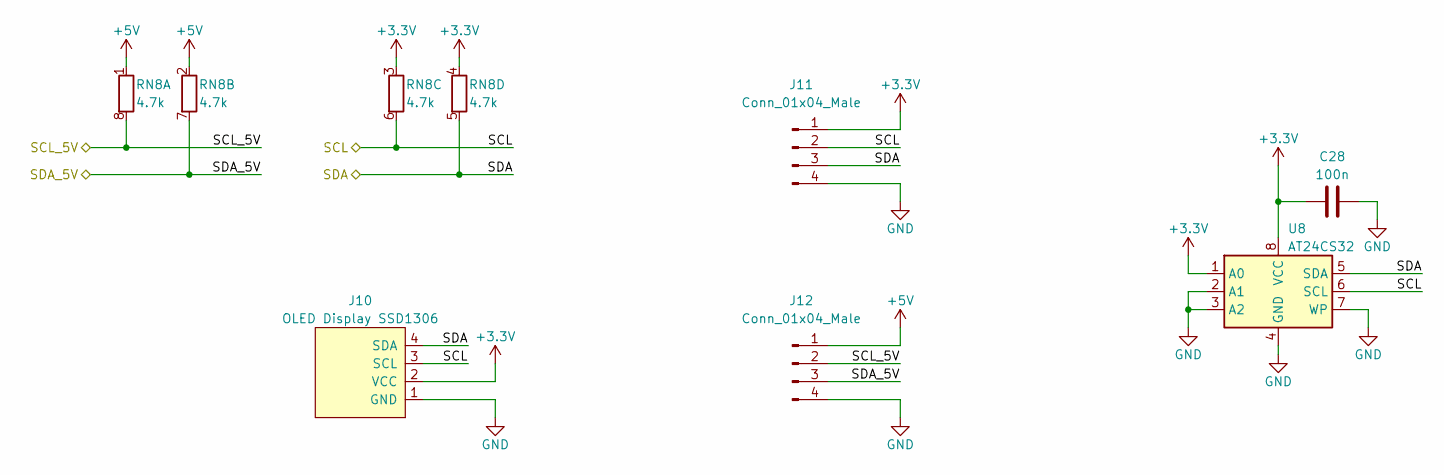
[picture p25: schematic i2c_devices.kicad_sch, Raspberry Pi Pico Kit]

Parts:
C28: 100n; C_0603_1608Metric_Pad1.08x0.95mm_HandSolder; Manufacturer Part Number C0805C104M3RAC7800
J10: OLED Display SSD1306; 128x64OLED; Manufacturer Part Number LA141008DI
J11, J12: Conn_01x04_Male; PinHeader_1x04_P2.54mm_Vertical; Manufacturer Part Number PinHeader_1x04
RN8: 4.7k; R_Array_Convex_4x0603
U8: AT24CS32; SOIC-8_3.9x4.9mm_P1.27mm; Manufacturer Part Number CAT24C32WI-GT3

Connections:
+3V3: C28.1, J10.2 (VCC), J11.1, RN8.3 (R3.1), RN8.4 (R4.1), U8.1 (A0), U8.8 (VCC); also elsewhere on the board
+5V: J12.1, RN8.1 (R1.1), RN8.2 (R2.1); also elsewhere on the board
/I2C_SCL: J10.3 (SCL), J11.2, RN8.6 (R3.2), U8.6 (SCL); also elsewhere on the board
/I2C_SCL_5V: J12.2, RN8.8 (R1.2); also elsewhere on the board
/I2C_SDA: J10.4 (SDA), J11.3, RN8.5 (R4.2), U8.5 (SDA); also elsewhere on the board
/I2C_SDA_5V: J12.3, RN8.7 (R2.2); also elsewhere on the board
GND: C28.2, J10.1 (GND), J11.4, J12.4, U8.2 (A1), U8.3 (A2), U8.4 (GND), U8.7 (WP); also elsewhere on the board

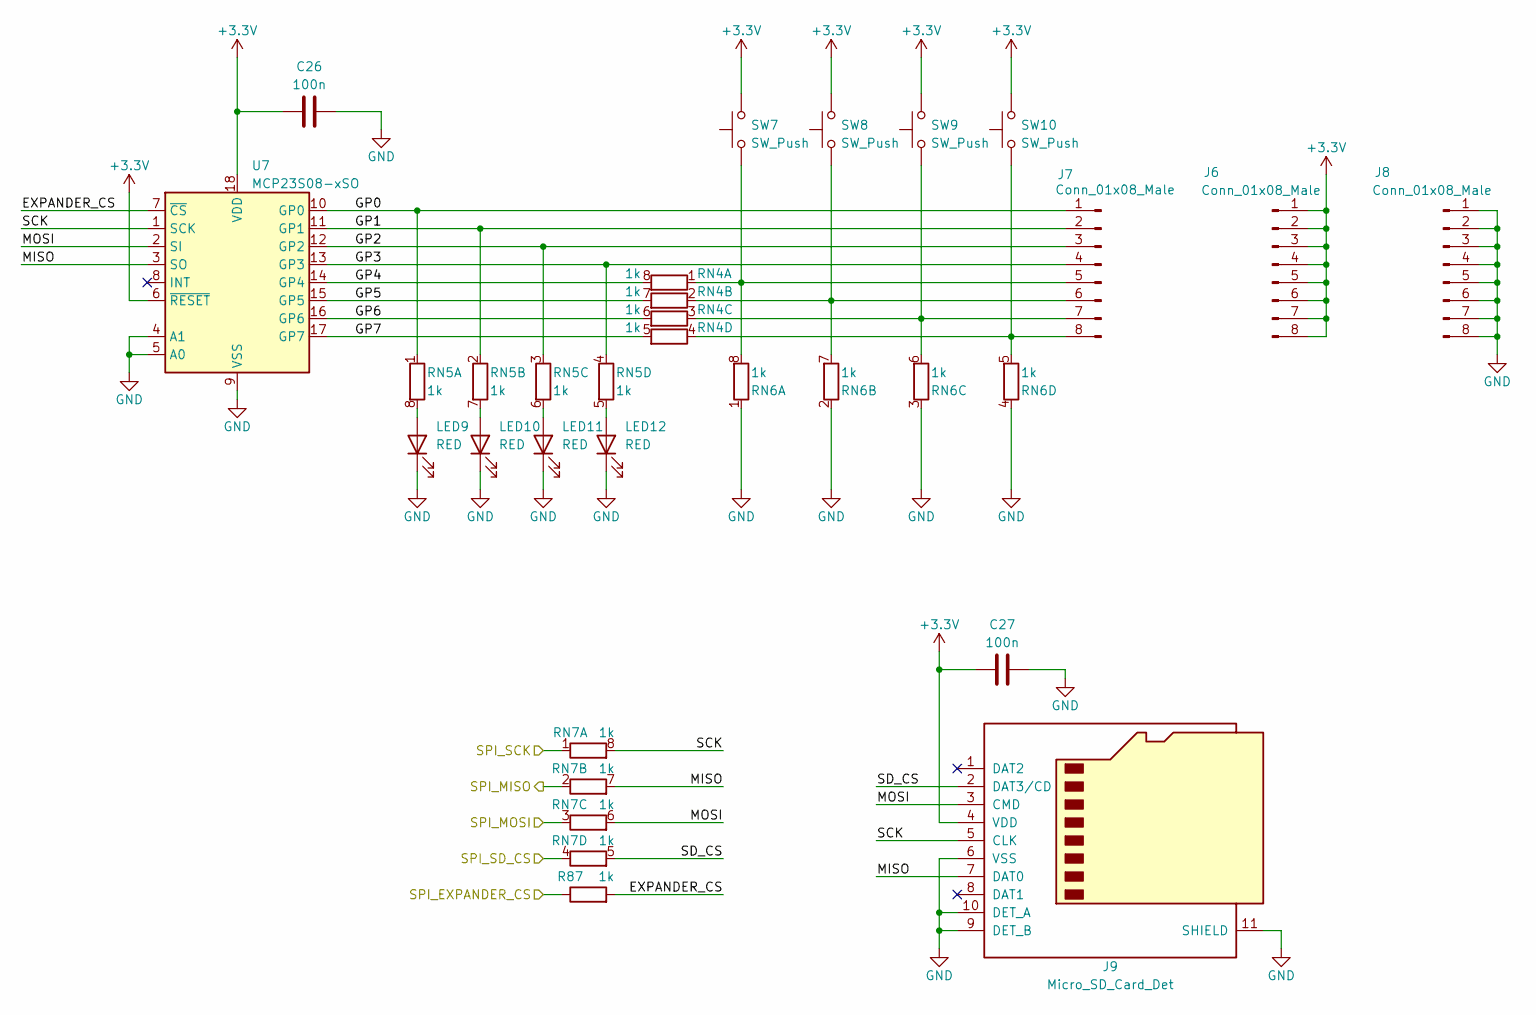
[picture p26: schematic spi_devices.kicad_sch, Raspberry Pi Pico Kit]

Parts:
C26, C27: 100n; C_0603_1608Metric_Pad1.08x0.95mm_HandSolder; Manufacturer Part Number C0805C104M3RAC7800
J6, J7, J8: Conn_01x08_Male; PinHeader_1x08_P2.54mm_Vertical; Manufacturer Part Number PinHeader_1x08
J9: Micro_SD_Card_Det; microSD_HC_Molex_104031-0811; Manufacturer Part Number 1040310811
LED9, LED10, LED11, LED12: RED; LED_0805_2012Metric_Pad1.15x1.40mm_HandSolder; Manufacturer Part Number 150080SS75000
R87: 1k; R_0603_1608Metric_Pad0.98x0.95mm_HandSolder; Manufacturer Part Number RC0805FR-071KL
RN4, RN5, RN6, RN7: 1k; R_Array_Convex_4x0603
SW7, SW8, SW9, SW10: SW_Push; SW_SPST_Omron_B3FS-100xP_12; Manufacturer Part Number TD-03XAT-A00-TR
U7: MCP23S08-xSO; SOIC-18W_7.5x11.6mm_P1.27mm; Manufacturer Part Number MCP23S08-E/SO

Connections:
+3V3: C26.1, C27.1, J6.1, J6.2, J6.3, J6.4, J6.5, J6.6, J6.7, J6.8, J9.4 (VDD), SW7.2, SW8.2, SW9.2, SW10.2, U7.6 (~RESET), U7.18 (VDD); also elsewhere on the board
/LED1: RN7.1 (R1.1); also elsewhere on the board
/LED2: RN7.3 (R3.1); also elsewhere on the board
/SPI Devices/EXPANDER_CS: R87.2, U7.7 (~CS)
/SPI Devices/GP0: J7.1, RN5.1 (R1.1), U7.10 (GP0)
/SPI Devices/GP1: J7.2, RN5.2 (R2.1), U7.11 (GP1)
/SPI Devices/GP2: J7.3, RN5.3 (R3.1), U7.12 (GP2)
/SPI Devices/GP3: J7.4, RN5.4 (R4.1), U7.13 (GP3)
/SPI Devices/GP4: RN4.8 (R1.2), U7.14 (GP4)
/SPI Devices/GP5: RN4.7 (R2.2), U7.15 (GP5)
/SPI Devices/GP6: RN4.6 (R3.2), U7.16 (GP6)
/SPI Devices/GP7: RN4.5 (R4.2), U7.17 (GP7)
/SPI Devices/MISO: J9.7 (DAT0), RN7.7 (R2.2), U7.3 (SO)
/SPI Devices/MOSI: J9.3 (CMD), RN7.6 (R3.2), U7.2 (SI)
/SPI Devices/SCK: J9.5 (CLK), RN7.8 (R1.2), U7.1 (SCK)
/SPI Devices/SD_CS: J9.2 (DAT3/CD), RN7.5 (R4.2)
/SPI_EXPANDER_CS: R87.1; also elsewhere on the board
/SPI_MISO: RN7.2 (R2.1); also elsewhere on the board
/SPI_SD_CS: RN7.4 (R4.1); also elsewhere on the board
GND: C26.2, C27.2, J8.1, J8.2, J8.3, J8.4, J8.5, J8.6, J8.7, J8.8, J9.6 (VSS), J9.9 (DET_B), J9.10 (DET_A), J9.11 (SHIELD), LED9.1 (K), LED10.1 (K), LED11.1 (K), LED12.1 (K), RN6.1 (R1.1), RN6.2 (R2.1), RN6.3 (R3.1), RN6.4 (R4.1), U7.4 (A1), U7.5 (A0), U7.9 (VSS); also elsewhere on the board
unnamed: J7.5, RN4.1 (R1.1), RN6.8 (R1.2), SW7.1
unnamed: J7.6, RN4.2 (R2.1), RN6.7 (R2.2), SW8.1
unnamed: J7.7, RN4.3 (R3.1), RN6.6 (R3.2), SW9.1
unnamed: J7.8, RN4.4 (R4.1), RN6.5 (R4.2), SW10.1
unnamed: LED9.2 (A), RN5.8 (R1.2)
unnamed: LED10.2 (A), RN5.7 (R2.2)
unnamed: LED11.2 (A), RN5.6 (R3.2)
unnamed: LED12.2 (A), RN5.5 (R4.2)
