999matej999/pico-kit-pcb/rpi_pico_kit/rpi_pico_kit.kicad_pcb

## KiCad design rpi_pico_kit/rpi_pico_kit.kicad_pcb (continued)

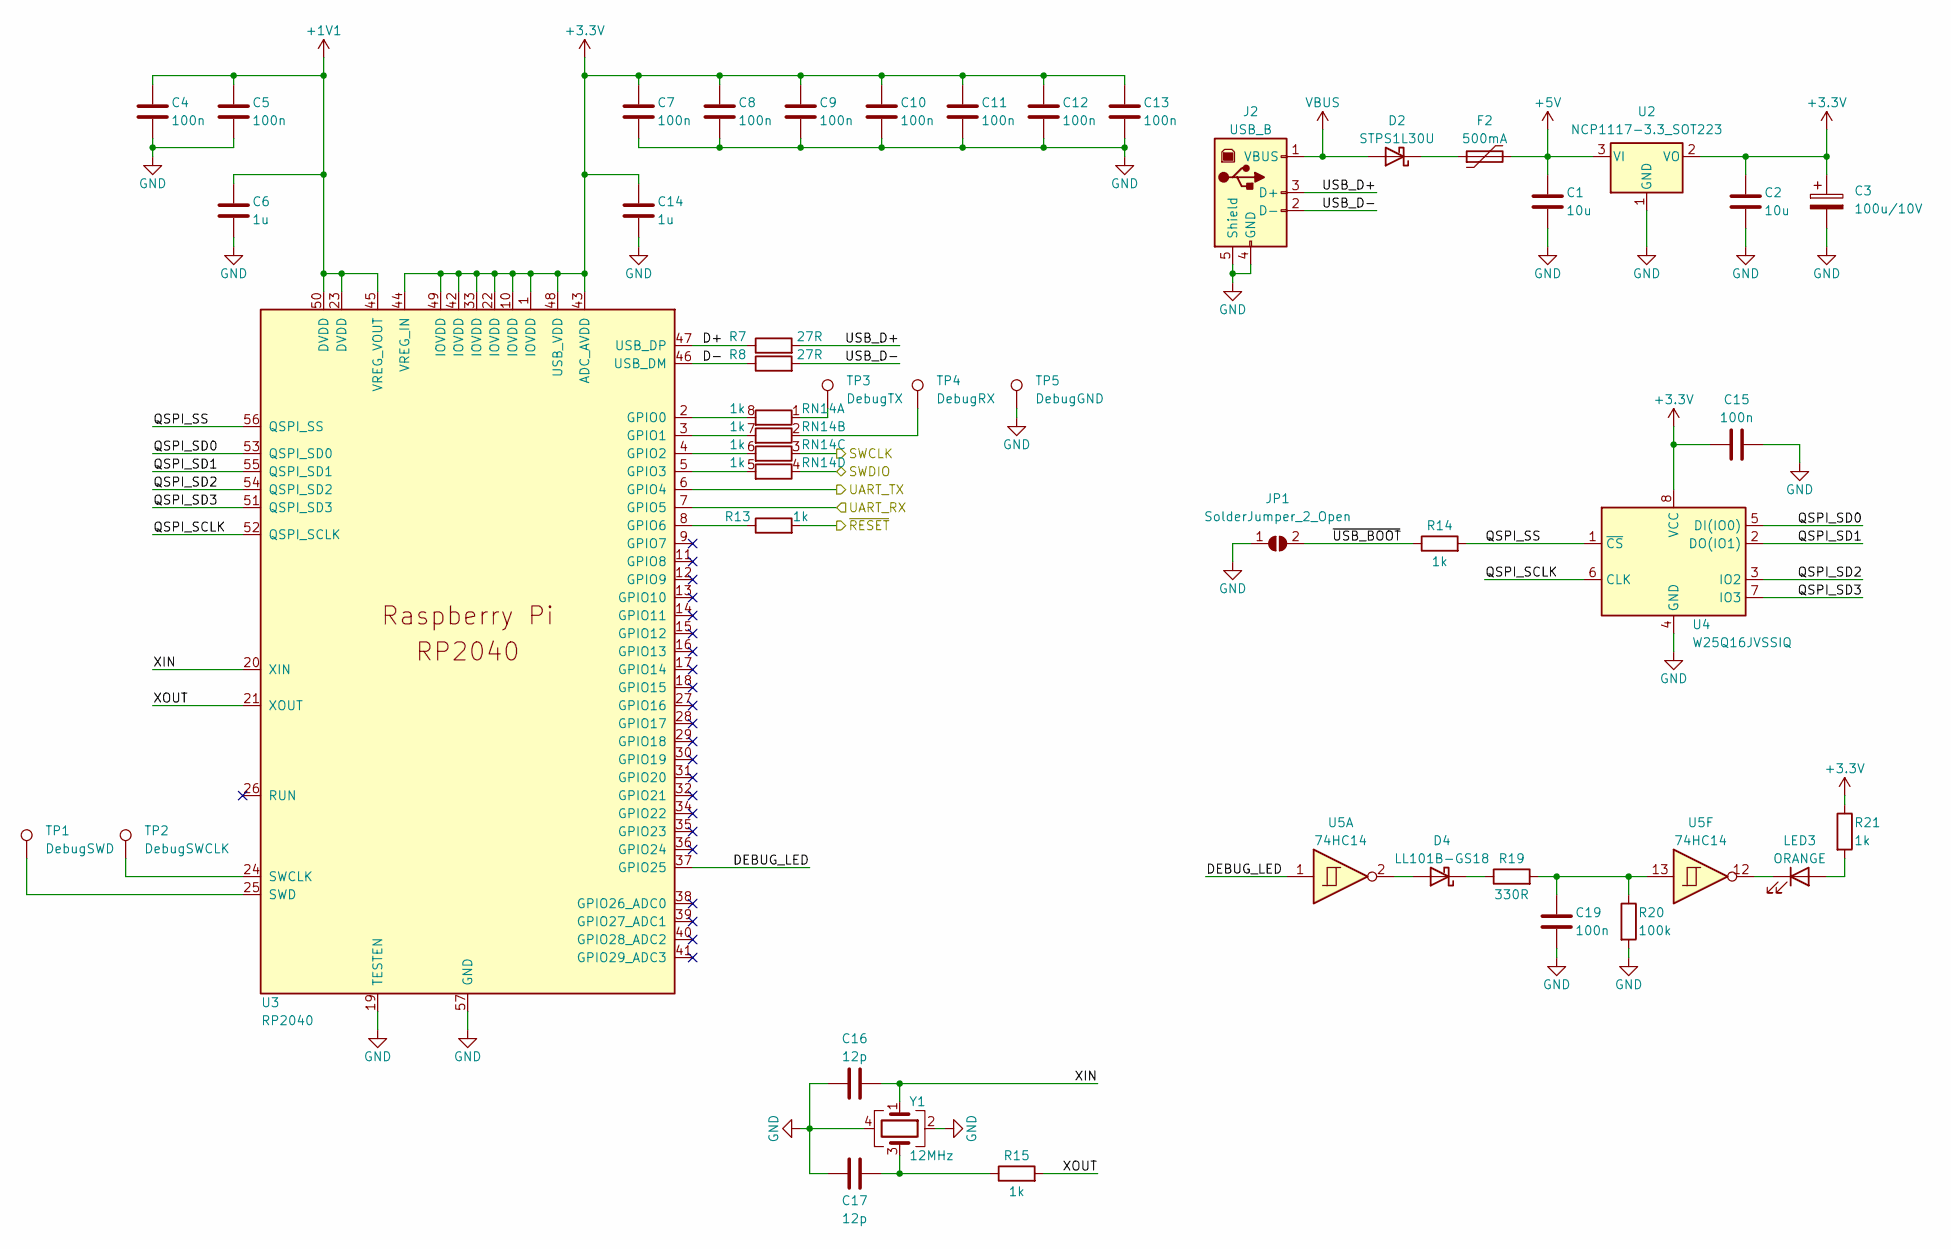
[picture p27: schematic debugger.kicad_sch, Raspberry Pi Pico Kit]

Parts:
C1, C2: 10u; C_0805_2012Metric_Pad1.18x1.45mm_HandSolder; Manufacturer Part Number CL21A106KOQNNNG
C3: 100u/10V; C_Elec_5x5.4; Manufacturer Part Number UWR1A101MCL1GB
C4, C5, C7, C8, C9, C10, C11, C12, C13, C15, C19: 100n; C_0603_1608Metric_Pad1.08x0.95mm_HandSolder; Manufacturer Part Number C0805C104M3RAC7800
C6, C14: 1u; C_0805_2012Metric_Pad1.18x1.45mm_HandSolder; Manufacturer Part Number C0805C105Z4VAC7800
C16, C17: 12p; C_0603_1608Metric_Pad1.08x0.95mm_HandSolder; Manufacturer Part Number C0805C120J1HAC7800
D2: STPS1L30U; D_SMB; Manufacturer Part Number STPS1L30U
D4: LL101B-GS18; D_MiniMELF; Manufacturer Part Number LL101B-GS18
F2: 500mA; Fuse_1206_3216Metric_Pad1.42x1.75mm_HandSolder; Manufacturer Part Number 0ZCJ0050FF2G
J2: USB_B; USB_B_Lumberg_2411_02_Horizontal; Manufacturer Part Number USB-B1HSW6
JP1: SolderJumper_2_Open; SolderJumper-2_P1.3mm_Open_RoundedPad1.0x1.5mm
LED3: ORANGE; LED_0805_2012Metric_Pad1.15x1.40mm_HandSolder; Manufacturer Part Number LTST-C170KFKT
R7, R8: 27R; R_0603_1608Metric_Pad0.98x0.95mm_HandSolder; Manufacturer Part Number RC0805FR-0727RL
R13, R14, R15, R21: 1k; R_0603_1608Metric_Pad0.98x0.95mm_HandSolder; Manufacturer Part Number RC0805FR-071KL
R19: 330R; R_0603_1608Metric_Pad0.98x0.95mm_HandSolder; Manufacturer Part Number RC0805FR-13330RL
R20: 100k; R_0603_1608Metric_Pad0.98x0.95mm_HandSolder; Manufacturer Part Number RC0805FR-07100KL
RN14: 1k; R_Array_Convex_4x0603
TP1: DebugSWD; TestPoint_Pad_D1.0mm
TP2: DebugSWCLK; TestPoint_Pad_D1.0mm
TP3: DebugTX; TestPoint_Pad_D1.0mm
TP4: DebugRX; TestPoint_Pad_D1.0mm
TP5: DebugGND; TestPoint_Pad_D1.0mm
U2: NCP1117-3.3_SOT223; SOT-223-3_TabPin2; Manufacturer Part Number NCP1117ST33T3G
U3: RP2040; RP2040-QFN-56; Manufacturer Part Number SC0914(13)
U4: W25Q16JVSSIQ; SOIC-8_5.275x5.275mm_P1.27mm; Manufacturer Part Number W25Q16JVSSIQ
U5: 74HC14; SOIC-14_3.9x8.7mm_P1.27mm; Manufacturer Part Number 74HC14S14-13
Y1: 12MHz; Crystal_SMD_0603-4Pin_6.0x3.5mm; Manufacturer Part Number ABM3B-12.000MHZ-10-1-U-T

Connections:
+1V1: C4.2, C5.2, C6.2, U3.23 (DVDD), U3.45 (VREG_VOUT), U3.50 (DVDD)
+3V3: C2.2, C3.1, C7.2, C8.2, C9.2, C10.2, C11.2, C12.2, C13.2, C14.2, C15.1, R21.1, U2.2 (VO), U3.1 (IOVDD), U3.10 (IOVDD), U3.22 (IOVDD), U3.33 (IOVDD), U3.42 (IOVDD), U3.43 (ADC_AVDD), U3.44 (VREG_IN), U3.48 (USB_VDD), U3.49 (IOVDD), U4.8 (VCC); also elsewhere on the board
+5V: C1.2, F2.2, U2.3 (VI); also elsewhere on the board
/DEBUGGER_RX: U3.6 (GPIO4); also elsewhere on the board
/DEBUGGER_TX: U3.7 (GPIO5); also elsewhere on the board
/Debugger/D+: R7.1, U3.47 (USB_DP)
/Debugger/D-: R8.1, U3.46 (USB_DM)
/Debugger/DEBUG_LED: U3.37 (GPIO25), U5.1
/Debugger/QSPI_SCLK: U3.52 (QSPI_SCLK), U4.6 (CLK)
/Debugger/QSPI_SD0: U3.53 (QSPI_SD0), U4.5 (DI(IO0))
/Debugger/QSPI_SD1: U3.55 (QSPI_SD1), U4.2 (DO(IO1))
/Debugger/QSPI_SD2: U3.54 (QSPI_SD2), U4.3 (IO2)
/Debugger/QSPI_SD3: U3.51 (QSPI_SD3), U4.7 (IO3)
/Debugger/QSPI_SS: R14.2, U3.56 (QSPI_SS), U4.1 (~CS)
/Debugger/USB_D+: J2.3 (D+), R7.2
/Debugger/USB_D-: J2.2 (D-), R8.2
/Debugger/XIN: C16.2, U3.20 (XIN), Y1.1
/Debugger/XOUT: R15.2, U3.21 (XOUT)
/Debugger/~USB_BOOT: JP1.2 (B), R14.1
/SWCLK: RN14.3 (R3.1); also elsewhere on the board
/SWDIO: RN14.4 (R4.1); also elsewhere on the board
/~RESET: R13.2; also elsewhere on the board
GND: C1.1, C2.1, C3.2, C4.1, C5.1, C6.1, C7.1, C8.1, C9.1, C10.1, C11.1, C12.1, C13.1, C14.1, C15.2, C16.1, C17.1, C19.1, J2.4 (GND), J2.5 (Shield), JP1.1 (A), R20.2, TP5.1, U2.1 (GND), U3.19 (TESTEN), U3.57 (GND), U4.4 (GND), Y1.2, Y1.4; also elsewhere on the board
unnamed: C17.2, R15.1, Y1.3
unnamed: C19.2, R19.2, R20.1, U5.13
unnamed: D2.1 (K), F2.1
unnamed: D4.2 (A), U5.2
unnamed: D4.1 (K), R19.1
unnamed: LED3.2 (A), R21.2
unnamed: LED3.1 (K), U5.12
unnamed: RN14.1 (R1.1), TP3.1
unnamed: RN14.8 (R1.2), U3.2 (GPIO0)
unnamed: RN14.2 (R2.1), TP4.1
unnamed: RN14.7 (R2.2), U3.3 (GPIO1)
unnamed: RN14.6 (R3.2), U3.4 (GPIO2)
unnamed: RN14.5 (R4.2), U3.5 (GPIO3)
unnamed: R13.1, U3.8 (GPIO6)
unnamed: TP2.1, U3.24 (SWCLK)
unnamed: TP1.1, U3.25 (SWD)
VBUS: D2.2 (A), J2.1 (VBUS)

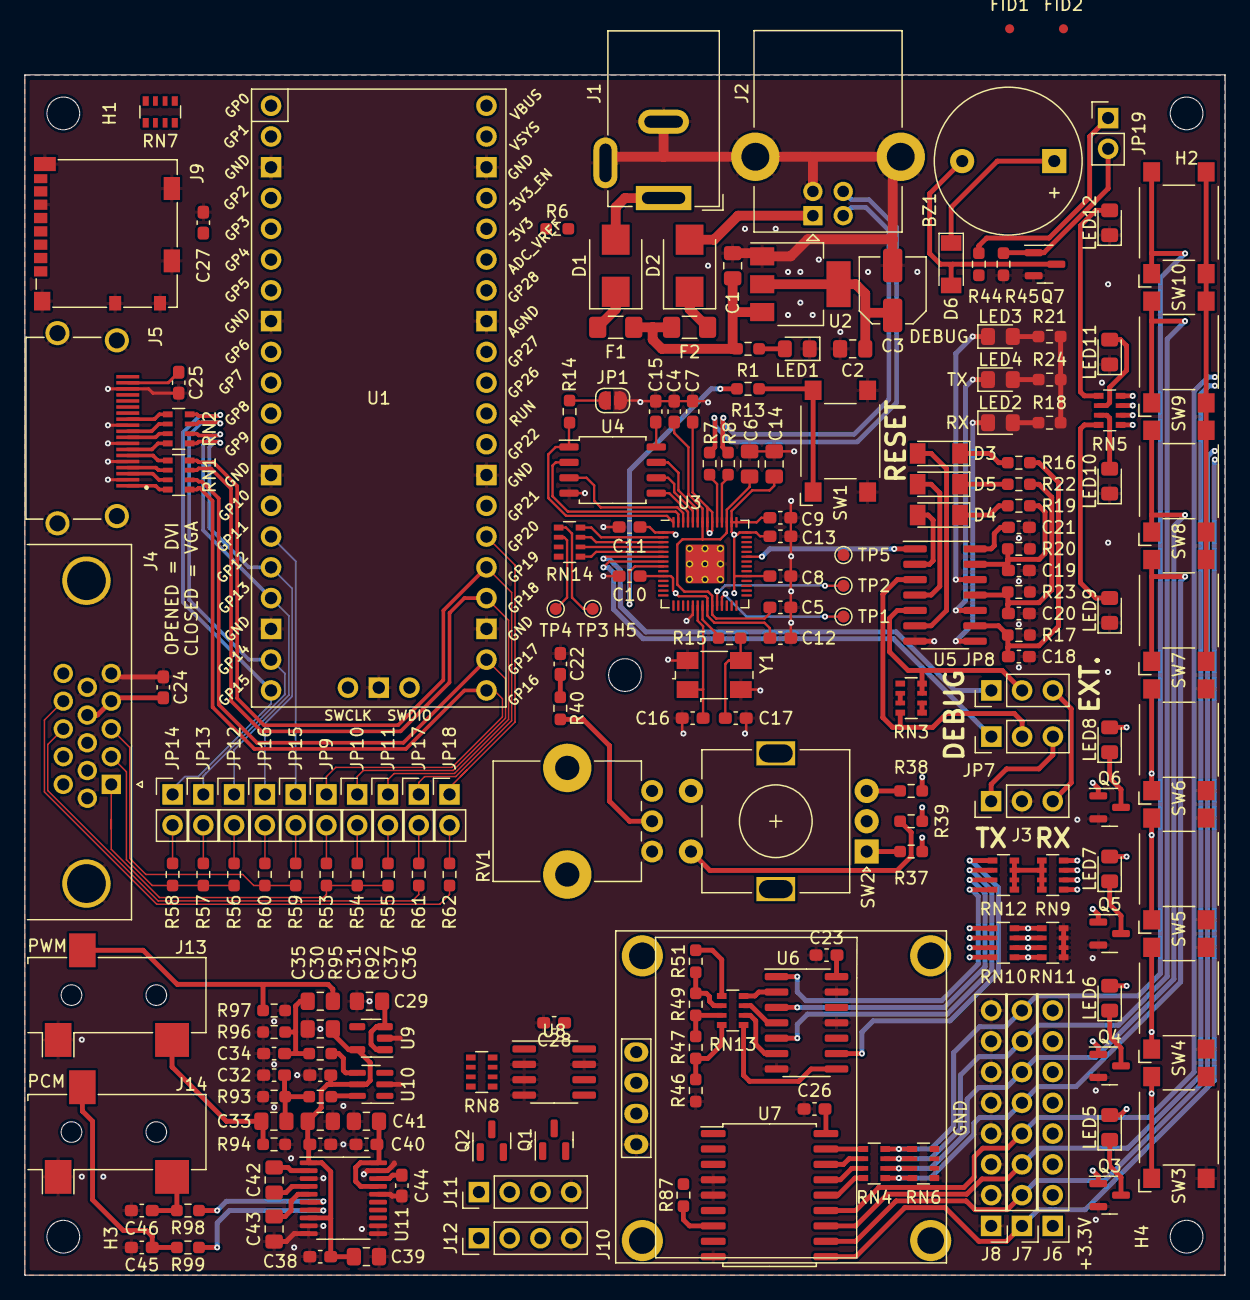
[picture p28: board rpi_pico_kit.kicad_pcb from above]

Board: 4 copper layers, 99.1 x 99.1 mm, 196 parts (0 on the bottom side), 175 nets.
