999matej999/pico-kit-pcb/(commit log)

2022-01-17 added kicad v6 project
    [Pico-R3.step, debugger.kicad_sch, rpi_pico_kit.kicad_pcb, rpi_pico_kit.kicad_sch]
2022-01-17 added second rpi pico as debugger
    [debugger.kicad_sch, rpi_pico_kit.kicad_pcb, rpi_pico_kit.kicad_sch]
2022-01-17 added pinout for rpi pico
    [kit_pinout.xlsx]
2022-01-17 added another components to schematic
    [basic_ui.kicad_sch, debugger.kicad_sch, rpi_pico_kit.kicad_pcb, rpi_pico_kit.kicad_sch, vga_dvi.kicad_sch]
2022-01-18 little changes
    [basic_ui.kicad_sch, kit_pinout.xlsx, rpi_pico_kit.kicad_sch]
2022-01-18 moved dac buttons to hierarchical sheet
    [basic_ui.kicad_sch, dac_buttons.kicad_sch, rpi_pico_kit.kicad_sch]
2022-01-18 removed dac buttons
    [basic_ui.kicad_sch, rpi_pico_kit.kicad_sch]
2022-01-18 added SPI devices
    [rpi_pico_kit.kicad_sch, spi_devices.kicad_sch]
2022-01-18 added i2c and audio interface
    [audio.kicad_sch, i2c_devices.kicad_sch, rpi_pico_kit.kicad_sch, spi_devices.kicad_sch]
2022-01-18 added leds for uart, little changes
    [basic_ui.kicad_sch, rpi_pico_kit.kicad_sch, spi_devices.kicad_sch]
2022-01-18 edited debugger
    [debugger.kicad_sch, rpi_pico_kit.kicad_sch, spi_devices.kicad_sch, vga_dvi.kicad_sch]
2022-01-18 edited debugger, little changes
    [audio.kicad_sch, debugger.kicad_sch, rpi_pico_kit.kicad_sch, spi_devices.kicad_sch, vga_dvi.kicad_sch]
2022-01-18 edited pinout
    [kit_pinout.xlsx, rpi_pico_kit.kicad_sch]
2022-01-18 renamed parts, added footprints
    [audio.kicad_sch, basic_ui.kicad_sch, debugger.kicad_sch, i2c_devices.kicad_sch, rpi_pico_kit.kicad_sch, spi_devices.kicad_sch, vga_dvi.kicad_sch]
2022-01-23 little changes, added EEPROM
    [audio.kicad_sch, basic_ui.kicad_sch, i2c_devices.kicad_sch, rpi_pico_kit.kicad_sch]
2022-01-23 added jumper for 74165's MISO pin
    [rpi_pico_kit.kicad_sch, spi_devices.kicad_sch]
2022-02-28 updated kicad version from 20211123 to 20220126
    [audio.kicad_sch, basic_ui.kicad_sch, debugger.kicad_sch, i2c_devices.kicad_sch, rpi_pico_kit.kicad_sch, spi_devices.kicad_sch, vga_dvi.kicad_sch]
2022-03-06 added i2c interface for vga and dvi
    [i2c_devices.kicad_sch, rpi_pico_kit.kicad_sch, vga_dvi.kicad_sch]
2022-03-06 added uart selector
    [rpi_pico_kit.kicad_sch]
2022-03-06 added some footprints
    [rpi_pico_kit.kicad_sch, vga_dvi.kicad_sch]
2022-03-06 added dac buttons
    [basic_ui.kicad_sch, rpi_pico_kit.kicad_sch]
2022-03-07 replaced spi expander
    [basic_ui.kicad_sch, rpi_pico_kit.kicad_sch, spi_devices.kicad_sch]
2022-03-07 replaced buttons in schematic
    [basic_ui.kicad_sch, rpi_pico_kit.kicad_sch]
2022-03-07 added resistors to expander's buttons
    [rpi_pico_kit.kicad_sch, spi_devices.kicad_sch]
2022-03-07 added i2c level shifters
    [i2c_devices.kicad_sch, rpi_pico_kit.kicad_sch]
2022-03-12 connected unused logic gates to ground
    [basic_ui.kicad_sch, rpi_pico_kit.kicad_sch]
2022-03-16 added bypass capacitor to schmitt inverter
    [basic_ui.kicad_sch, rpi_pico_kit.kicad_sch]
2022-03-17 changed schematic for uart leds
    [basic_ui.kicad_sch, rpi_pico_kit.kicad_sch]
2022-03-18 added jumpers to vga
    [rpi_pico_kit.kicad_sch, vga_dvi.kicad_sch]
2022-03-18 changed pinout
    [basic_ui.kicad_sch, rpi_pico_kit.kicad_sch]
2022-03-18 changed transistors to unused gates of 7414
    [basic_ui.kicad_sch, debugger.kicad_sch, rpi_pico_kit.kicad_sch]
2022-03-18 added test pads for uart and swd of debugger
    [debugger.kicad_sch, i2c_devices.kicad_sch, rpi_pico_kit.kicad_sch, vga_dvi.kicad_sch]
2022-03-18 changed encoder button pull-up to pull-down
    [basic_ui.kicad_sch, rpi_pico_kit.kicad_sch]
2022-03-18 added some MPNs, added fiducials
    [debugger.kicad_sch, i2c_devices.kicad_sch, rpi_pico_kit.kicad_sch]
2022-03-19 edited 5V I2C, added some footprints, MPNs, added HDMI footprint library
    [SS-53000-001.step, basic_ui.kicad_sch, debugger.kicad_sch, i2c_devices.kicad_sch, rpi_pico_kit.kicad_sch, spi_devices.kicad_sch, vga_dvi.kicad_sch]
2022-03-19 added some footprints and MPNs
    [audio.kicad_sch, basic_ui.kicad_sch, i2c_devices.kicad_sch, rpi_pico_kit.kicad_sch]
2022-03-19 added MPNs for capacitors
    [audio.kicad_sch, basic_ui.kicad_sch, debugger.kicad_sch, i2c_devices.kicad_sch, rpi_pico_kit.kicad_sch, spi_devices.kicad_sch, vga_dvi.kicad_sch]
2022-03-19 added MPNs for resistors
    [audio.kicad_sch, basic_ui.kicad_sch, debugger.kicad_sch, i2c_devices.kicad_sch, rpi_pico_kit.kicad_sch, spi_devices.kicad_sch, vga_dvi.kicad_sch]
2022-03-19 added another MPNs, edited color of LEDs
    [audio.kicad_sch, basic_ui.kicad_sch, debugger.kicad_sch, i2c_devices.kicad_sch, rpi_pico_kit.kicad_sch, spi_devices.kicad_sch, vga_dvi.kicad_sch]
2022-03-19 added monostable for debug led
    [debugger.kicad_sch, rpi_pico_kit.kicad_sch]
2022-03-19 changed back 7414 gates to mosfets
    [basic_ui.kicad_sch, debugger.kicad_sch, rpi_pico_kit.kicad_sch]
2022-03-19 added missing MPNs to edited parts
    [audio.kicad_sch, basic_ui.kicad_sch, rpi_pico_kit.kicad_sch]
2022-03-19 changed name of LEDs from D to LED
    [basic_ui.kicad_sch, debugger.kicad_sch, rpi_pico_kit.kicad_sch, spi_devices.kicad_sch]
2022-03-19 added MPNs
    [audio.kicad_sch, basic_ui.kicad_sch, debugger.kicad_sch, i2c_devices.kicad_sch, rpi_pico_kit.kicad_sch, spi_devices.kicad_sch, vga_dvi.kicad_sch]
2022-03-19 added micro sd footprint and MPN
    [rpi_pico_kit.kicad_sch, spi_devices.kicad_sch]
2022-03-19 added protective diode to buzzer
    [audio.kicad_sch, rpi_pico_kit.kicad_sch]
2022-03-19 added SSD1306 library
    [i2c_devices.kicad_sch, rpi_pico_kit.kicad_sch]
2022-03-19 migrated library SSD1306, added footprint
    [i2c_devices.kicad_sch, rpi_pico_kit.kicad_sch]
2022-03-19 changed numbering of parts
    [audio.kicad_sch, basic_ui.kicad_sch, debugger.kicad_sch, i2c_devices.kicad_sch, rpi_pico_kit.kicad_sch, spi_devices.kicad_sch, vga_dvi.kicad_sch]
2022-03-20 added solder jumpers to swd, changed numbering of parts
    [audio.kicad_sch, basic_ui.kicad_sch, debugger.kicad_sch, i2c_devices.kicad_sch, rpi_pico_kit.kicad_sch, spi_devices.kicad_sch, vga_dvi.kicad_sch]
2022-03-20 changed uart pin headers to jumpers
    [rpi_pico_kit.kicad_sch]
2022-03-20 added PTC fuses
    [debugger.kicad_sch, rpi_pico_kit.kicad_sch]
2022-03-20 added empty pcb file
    [rpi_pico_kit.kicad_pcb]
2022-03-20 added parts to pcb
    [rpi_pico_kit.kicad_pcb]
2022-03-20 added some 3D models
    [CUI_DEVICES_SJ-3523-SMT-TR.step, Pico-R3.step, audio.kicad_sch, rpi_pico_kit.kicad_pcb]
2022-03-20 changed switches from tht to smd
    [basic_ui.kicad_sch, rpi_pico_kit.kicad_pcb, rpi_pico_kit.kicad_sch, spi_devices.kicad_sch]
2022-03-20 changed footprint for tactile switches, added 3D model
    [B3FS_1000.step, basic_ui.kicad_sch, rpi_pico_kit.kicad_pcb, rpi_pico_kit.kicad_sch, spi_devices.kicad_sch]
2022-03-20 changed tactile switch 3D model
    [B3FS_1000.step]
2022-03-20 added 3D models, repaired SSD1306 footprint
    [54-00129.step, EN11-HSM1BF20.step, OLED-128x64-0.96.step, audio.kicad_sch, ptv09a-4x20f-xxxx.stp, rpi_pico_kit.kicad_pcb, rpi_pico_kit.kicad_sch]
2022-03-20 added sim card 3D model
    [1040310811.stp, rpi_pico_kit.kicad_pcb]
2022-03-20 changed footprint for flash memory
    [debugger.kicad_sch, rpi_pico_kit.kicad_pcb, rpi_pico_kit.kicad_sch]
2022-03-20 added USB B 3D model
    [USB-B.stp, rpi_pico_kit.kicad_pcb]
2022-03-20 changed footprint for crystal
    [debugger.kicad_sch, rpi_pico_kit.kicad_pcb, rpi_pico_kit.kicad_sch]
2022-03-20 added OLED socket
    [rpi_pico_kit.kicad_pcb]
2022-03-20 added RPi Pico socket
    [rpi_pico_kit.kicad_pcb]
2022-03-20 repaired switch 3D model
    [rpi_pico_kit.kicad_pcb]
2022-03-21 added JumperTHT library
    [jumper.stp]
2022-03-21 changed footprint for THT jumpers to use jumper 3D model
    [audio.kicad_sch, rpi_pico_kit.kicad_pcb, rpi_pico_kit.kicad_sch, vga_dvi.kicad_sch]
2022-03-21 changed RV1 3D model
    [rpi_pico_kit.kicad_pcb]
2022-03-21 changed potentiometer footprint
    [basic_ui.kicad_sch, rpi_pico_kit.kicad_pcb, rpi_pico_kit.kicad_sch]
2022-03-21 edited board setup
    [rpi_pico_kit.kicad_pcb]
2022-03-21 edited mask clearance
    [rpi_pico_kit.kicad_pcb]
2022-03-21 created Custom library with custom SMD button switch
    [basic_ui.kicad_sch, rpi_pico_kit.kicad_pcb, rpi_pico_kit.kicad_sch, spi_devices.kicad_sch]
2022-03-21 updated kicad version from 20220211 to 20220308
    [rpi_pico_kit.kicad_pcb]
2022-03-21 edited OLED footprint
    [rpi_pico_kit.kicad_pcb]
2022-03-21 removed additional holes for oled
    [basic_ui.kicad_sch, debugger.kicad_sch, i2c_devices.kicad_sch, rpi_pico_kit.kicad_pcb, rpi_pico_kit.kicad_sch]
2022-03-21 initial changes in pcb, drawn pcb outline
    [rpi_pico_kit.kicad_pcb]
2022-03-21 filtered controls and indicators
    [rpi_pico_kit.kicad_pcb]
2022-03-21 changed position of controls and indicators
    [rpi_pico_kit.kicad_pcb]
2022-03-21 added rpi pico THT and SMD footprint
2022-03-21 edited RPi Pico SMD and THT footprint
2022-03-21 edited RPi Pico THT library
2022-03-21 changed rpi pico footprint in project
    [rpi_pico_kit.kicad_pcb, rpi_pico_kit.kicad_sch]
2022-03-21 pcb changes
    [rpi_pico_kit.kicad_pcb, rpi_pico_kit.kicad_sch, vga_dvi.kicad_sch]
2022-03-22 changed resistors to resistor arrays
    [basic_ui.kicad_sch, debugger.kicad_sch, i2c_devices.kicad_sch, rpi_pico_kit.kicad_sch, spi_devices.kicad_sch, vga_dvi.kicad_sch]
2022-03-22 added footprints for resistor arrays
    [basic_ui.kicad_sch, debugger.kicad_sch, i2c_devices.kicad_sch, rpi_pico_kit.kicad_pcb, rpi_pico_kit.kicad_sch, spi_devices.kicad_sch]
2022-03-22 added missing footprints
    [basic_ui.kicad_sch, debugger.kicad_sch, i2c_devices.kicad_sch, rpi_pico_kit.kicad_sch, spi_devices.kicad_sch]
2022-03-22 downgraded kicad version from 20220308 to 20220211
    [basic_ui.kicad_sch, debugger.kicad_sch, i2c_devices.kicad_sch, rpi_pico_kit.kicad_pcb, rpi_pico_kit.kicad_sch, spi_devices.kicad_sch, vga_dvi.kicad_sch]
2022-03-22 added resistor arrays to pcb
    [rpi_pico_kit.kicad_pcb]
2022-03-22 changed footprints from 0805 to 0603
    [audio.kicad_sch, basic_ui.kicad_sch, debugger.kicad_sch, i2c_devices.kicad_sch, rpi_pico_kit.kicad_pcb, rpi_pico_kit.kicad_sch, spi_devices.kicad_sch, vga_dvi.kicad_sch]
2022-03-22 changed footprint U10
    [audio.kicad_sch, rpi_pico_kit.kicad_pcb, rpi_pico_kit.kicad_sch]
2022-03-22 SPI conflict solved
    [basic_ui.kicad_sch, rpi_pico_kit.kicad_pcb, rpi_pico_kit.kicad_sch, spi_devices.kicad_sch]
2022-03-22 changed footprint for diodes
    [debugger.kicad_sch, rpi_pico_kit.kicad_pcb, rpi_pico_kit.kicad_sch]
2022-03-22 rearranged parts to blocks
    [rpi_pico_kit.kicad_pcb]
2022-03-22 added RPi Pico THT socket footprint
2022-03-22 added RPi Pico THT socket 3D model
2022-03-22 changed RPi Pico footprint in pcb
    [rpi_pico_kit.kicad_pcb, rpi_pico_kit.kicad_sch]
2022-03-22 changed footprints for resistor arrays
    [basic_ui.kicad_sch, debugger.kicad_sch, i2c_devices.kicad_sch, rpi_pico_kit.kicad_pcb, rpi_pico_kit.kicad_sch, spi_devices.kicad_sch, vga_dvi.kicad_sch]
2022-03-22 added names to differential pairs
    [debugger.kicad_sch, rpi_pico_kit.kicad_pcb, vga_dvi.kicad_sch]
2022-03-22 updated pcb netlist
    [rpi_pico_kit.kicad_pcb]
2022-03-22 added net classes
    [rpi_pico_kit.kicad_pcb]
2022-03-24 replaced audio
    [rpi_pico_kit.kicad_pcb]
2022-03-24 4 layer stackup
    [rpi_pico_kit.kicad_pcb]
2022-03-24 edited layer thickness
    [rpi_pico_kit.kicad_pcb]
2022-03-25 added permitivity of JLC 7628 stackup
    [rpi_pico_kit.kicad_pcb]
2022-03-25 edited thickness of prepregs layers
    [rpi_pico_kit.kicad_pcb]
2022-03-25 added differential dvi lines (unrouted 523)
    [rpi_pico_kit.kicad_pcb]
2022-03-25 added GND filed zones (unrouted 421)
    [rpi_pico_kit.kicad_pcb]
2022-03-25 added nets to vga class
    [rpi_pico_kit.kicad_pcb, vga_dvi.kicad_sch]
2022-03-25 vga (unrouted 401)
    [rpi_pico_kit.kicad_pcb]
2022-03-25 vga (unrouted 389)
    [rpi_pico_kit.kicad_pcb]
2022-03-25 updated GND plane
    [rpi_pico_kit.kicad_pcb]
2022-03-25 moved text
    [rpi_pico_kit.kicad_pcb]
2022-03-25 changed eeprom I2C address from 0x50 to 0x51
    [i2c_devices.kicad_sch, rpi_pico_kit.kicad_pcb, rpi_pico_kit.kicad_sch]
2022-03-26 solved some DRC errors
    [rpi_pico_kit.kicad_pcb]
2022-03-26 audio (unrouted 353)
    [rpi_pico_kit.kicad_pcb]
2022-03-26 added GND vias to audio
    [rpi_pico_kit.kicad_pcb]
2022-03-26 spi (unrouted 319)
    [rpi_pico_kit.kicad_pcb, spi_devices.kicad_sch]
2022-03-26 edited VGA tracks width
    [rpi_pico_kit.kicad_pcb]
2022-03-26 basic leds (unrouted 295)
    [basic_ui.kicad_sch, rpi_pico_kit.kicad_pcb]
2022-03-26 dac buttons (unrouted 270)
    [basic_ui.kicad_sch, rpi_pico_kit.kicad_pcb]
2022-03-26 updated GND plane (unrouted 262)
    [rpi_pico_kit.kicad_pcb]
2022-03-26 potentiomete, encoder (unrouted 257)
    [rpi_pico_kit.kicad_pcb]
2022-03-26 expander (unrouted 234)
    [rpi_pico_kit.kicad_pcb]
2022-03-26 added 5th hole at the center
    [rpi_pico_kit.kicad_pcb, rpi_pico_kit.kicad_sch]
2022-03-27 buzzer (unrouted 226)
    [rpi_pico_kit.kicad_pcb]
2022-03-27 power (unrouted 221)
    [rpi_pico_kit.kicad_pcb]
2022-03-27 power (unrouted 209)
    [rpi_pico_kit.kicad_pcb]
2022-03-27 moved debugger (unrouted 190)
    [rpi_pico_kit.kicad_pcb]
2022-03-27 debugger (unrouted 171)
    [rpi_pico_kit.kicad_pcb]
2022-03-27 debugger (unrouted 163)
    [debugger.kicad_sch, rpi_pico_kit.kicad_pcb, rpi_pico_kit.kicad_sch]
2022-03-27 debugger (unrouted 159)
    [rpi_pico_kit.kicad_pcb]
2022-03-27 crystal (unrouted 155)
    [rpi_pico_kit.kicad_pcb]
2022-03-27 little changes (unrouted 153)
    [rpi_pico_kit.kicad_pcb]
2022-03-27 reset, test pads (unrouted 139)
    [rpi_pico_kit.kicad_pcb]
2022-03-27 monostable (unrouted 136)
    [debugger.kicad_sch, rpi_pico_kit.kicad_pcb, rpi_pico_kit.kicad_sch]
2022-03-27 monostable (unrouted 115)
    [rpi_pico_kit.kicad_pcb]
2022-03-27 monostable (unrouted 112)
    [rpi_pico_kit.kicad_pcb]
2022-03-27 monostable (unrouted 105)
    [rpi_pico_kit.kicad_pcb]
2022-03-27 little changes (unrouted 104)
    [rpi_pico_kit.kicad_pcb]
2022-03-28 solved some errors and warnings
    [rpi_pico_kit.kicad_pcb]
2022-03-28 monostable leds (unrouted 99)
    [audio.kicad_sch, rpi_pico_kit.kicad_pcb, rpi_pico_kit.kicad_sch]
2022-03-28 monostable leds (unrouted 96)
    [rpi_pico_kit.kicad_pcb]
2022-03-28 updated GND plane, added GND vias
2022-03-28 sd card (unrouted 92)
    [rpi_pico_kit.kicad_sch, spi_devices.kicad_sch]
2022-03-28 sd card (unrouted 87)
    [rpi_pico_kit.kicad_sch, spi_devices.kicad_sch]
2022-03-28 i2c (unrouted 74)
    [i2c_devices.kicad_sch, rpi_pico_kit.kicad_sch]
2022-03-28 5V supply (unrouted 35)
2022-03-28 i2c, swd (unrouted 27)
2022-03-28 i2c (unrouted 25)
2022-03-29 schematic cleared annotation
    [audio.kicad_sch, basic_ui.kicad_sch, debugger.kicad_sch, i2c_devices.kicad_sch, rpi_pico_kit.kicad_sch, spi_devices.kicad_sch, vga_dvi.kicad_sch]
2022-03-29 renumbered parts
    [audio.kicad_sch, basic_ui.kicad_sch, debugger.kicad_sch, i2c_devices.kicad_sch, rpi_pico_kit.kicad_sch, spi_devices.kicad_sch, vga_dvi.kicad_sch]
2022-03-29 renumbered pwr
    [audio.kicad_sch, basic_ui.kicad_sch, debugger.kicad_sch, i2c_devices.kicad_sch, rpi_pico_kit.kicad_sch, spi_devices.kicad_sch, vga_dvi.kicad_sch]
2022-03-29 renumbered pcb
2022-03-29 added some description
    [debugger.kicad_sch, rpi_pico_kit.kicad_sch]
2022-03-29 changed resistor value
    [rpi_pico_kit.kicad_sch, spi_devices.kicad_sch]
2022-03-29 changed dimensions of pcb to 10x10cm
2022-03-29 sd card, i2c (unrouted 14)
2022-03-29 encoder, uart (unrouted 10)
2022-03-29 another connections to pico (unrouted 5)
2022-03-29 leds (unrouted 3)
2022-03-30 added GND vias
2022-03-30 added board dimensions
2022-03-30 added some MPNs
    [audio.kicad_sch, basic_ui.kicad_sch, debugger.kicad_sch, i2c_devices.kicad_sch, rpi_pico_kit.kicad_sch, spi_devices.kicad_sch, vga_dvi.kicad_sch]
2022-03-30 changed potentiometer MPN
    [basic_ui.kicad_sch]
2022-03-30 updated MPNs in pcb
2022-03-30 added gerber files
    [rpi_pico_kit-B_Cu.gbl, rpi_pico_kit-B_Mask.gbs, rpi_pico_kit-B_Paste.gbp, rpi_pico_kit-B_Silkscreen.gbo, rpi_pico_kit-Edge_Cuts.gm1, rpi_pico_kit-F_Cu.gtl, rpi_pico_kit-F_Mask.gts, rpi_pico_kit-F_Paste.gtp]
2022-03-30 added drill files
    [rpi_pico_kit-NPTH.drl, rpi_pico_kit-PTH.drl]
2022-03-30 added map files
    [rpi_pico_kit-NPTH-drl_map.gbr, rpi_pico_kit-PTH-drl_map.gbr]
2022-03-30 gerber settings
2022-03-31 edited gerber files
    [rpi_pico_kit-B_Cu.gbl, rpi_pico_kit-B_Mask.gbs, rpi_pico_kit-B_Paste.gbp, rpi_pico_kit-B_Silkscreen.gbo, rpi_pico_kit-Edge_Cuts.gm1, rpi_pico_kit-F_Cu.gtl, rpi_pico_kit-F_Mask.gts, rpi_pico_kit-F_Paste.gtp]
2022-04-07 changed date and revision number
    [audio.kicad_sch, basic_ui.kicad_sch, debugger.kicad_sch, i2c_devices.kicad_sch, rpi_pico_kit.kicad_sch, spi_devices.kicad_sch, vga_dvi.kicad_sch]
2022-04-07 visual changes in schematic
    [basic_ui.kicad_sch, debugger.kicad_sch, i2c_devices.kicad_sch, rpi_pico_kit.kicad_sch, spi_devices.kicad_sch]
2022-04-11 added gerber data zip
2022-05-15 updated pinout name BUZZER-> PIEZO
    [audio.kicad_sch, kit_pinout.xlsx, rpi_pico_kit.kicad_sch]
