999matej999/pico-kit-pcb/(notices)

Notices in the files:
rpi_pico_kit/3D_models/jumper.stp:
FILE_NAME( 'e:/temp/worker_63/temp/exporttempdir_3220_1658_jvh3T/format_0/SNT-100-RD-H.stp', '2022-03-20T23:57:31', ( 'License CC BY-ND 4.0' ), ( 'CADENAS' ), ' ', 'PARTsolutions', ' ' );
rpi_pico_kit/3D_models/USB-B.stp:
FILE_NAME( 'e:/temp/worker_82/temp/exporttempdir_4468_1084_BMJQN/format_0/USB-B-S-S-B-TH-TR.stp', '2022-03-20T23:02:04', ( 'License CC BY-ND 4.0' ), ( 'CADENAS' ), ' ', 'PARTsolutions', ' ' );
